anand2532/TokenKey-RT/docs/README.md

# docs

Project documentation: baseline specifications, design decisions, pin mapping, test plans and bring-up notes.
