anand2532/TokenKey-RT/software/poc-prototype/data/README.md

Data is not committed. Run ../fetch_data.sh from software/poc-prototype/ to recreate it.
