anand2532/TokenKey-RT/enclosure/exports/interference_report.md

# Interference check

Board ref e2e5ff9; clash threshold 0.3 mm; header 3.0, module 2.65, J2 y 5.0, shaft tip 24.5, knob H 16.5.

Pairs checked (bbox within 3 mm): 384; CLASH/TIGHT: 0

| kind | A | B | min clearance (mm) | overlap (mm3) | status |
|---|---|---|---|---|---|
| part-board | top_shell | pcb | 0.00 | 0.000 | fit/contact |
| part-board | bottom_tray | pcb | 0.00 | 0.000 | fit/contact |
| part-part | top_shell | bottom_tray | 0.00 | 0.000 | fit/contact |
| part-part | top_shell | button_cap_btn1 | 0.00 | 0.000 | fit/contact |
| part-part | top_shell | button_cap_btn2 | 0.00 | 0.000 | fit/contact |
| part-part | top_shell | light_pipe | 0.00 | 0.000 | fit/contact |
| part-part | bottom_tray | hatch_cover | 0.00 | 0.000 | fit/contact |
| part-part | bottom_tray | ballast | 0.00 | 0.000 | fit/contact |
| part-part | bottom_tray | feet | 0.00 | 0.000 | fit/contact |
| part-part | hatch_cover | feet | 0.00 | 0.000 | fit/contact |
| part-part | knob | knob_sleeve | 0.01 | 0.000 | fit/contact |
| part-board | knob_sleeve | SW2 EC11 body+shaft | 0.02 | 0.000 | fit/contact |
| part-board | top_shell | OLED module PCB | 0.15 | 0.000 | fit/contact |
| motion | knob@full-push | top_shell | 0.15 | 0.000 | fit/contact |
| part-part | top_shell | knob | 0.15 | 0.000 | fit/contact |
| part-board | light_pipe | D1 (LED) | 0.20 | 0.000 | fit/contact |
| part-board | button_cap_btn1 | SW3 (SW) | 0.21 | 0.000 | fit/contact |
| part-board | button_cap_btn2 | SW4 (SW) | 0.21 | 0.000 | fit/contact |
| part-board | top_shell | J1 USB-C body | 0.30 | 0.000 | ok |
| part-board | bottom_tray | SW1 (SW) | 0.30 | 0.000 | ok |
| part-board | top_shell | OLED glass | 0.35 | 0.000 | ok |
| part-board | top_shell | OLED FPC bend | 0.35 | 0.000 | ok |
| part-board | ballast | C3 (C DNP) | 0.35 | 0.000 | ok |
| part-board | ballast | C40 (C) | 0.35 | 0.000 | ok |
| part-board | ballast | C4 (C DNP) | 0.35 | 0.000 | ok |
| part-board | ballast | THT tails | 0.48 | 0.000 | ok |
| part-board | top_shell | SW2 EC11 body+shaft | 0.50 | 0.000 | ok |
| part-board | bottom_tray | L1 (L DNP) | 0.50 | 0.000 | ok |
| part-board | button_cap_btn1 | pcb | 0.50 | 0.000 | ok |
| part-board | button_cap_btn2 | pcb | 0.50 | 0.000 | ok |
| part-board | knob | SW2 EC11 body+shaft | 0.50 | 0.000 | ok |
| part-board | ballast | L1 (L DNP) | 0.50 | 0.000 | ok |
| part-board | ballast | SW1 (SW) | 0.50 | 0.000 | ok |
| part-board | ballast | U3 (SOT-23-5 DNP) | 0.51 | 0.000 | ok |
| part-part | ballast | feet | 0.60 | 0.000 | ok |
| part-board | top_shell | U4 (SOIC-8) | 0.60 | 0.000 | ok |
| part-board | ballast | C28 (C) | 0.75 | 0.000 | ok |
| part-board | ballast | C27 (C) | 0.75 | 0.000 | ok |
| part-board | ballast | C36 (C) | 0.75 | 0.000 | ok |
| part-board | ballast | C31 (C) | 0.75 | 0.000 | ok |
| part-board | ballast | C7 (C) | 0.75 | 0.000 | ok |
| part-board | ballast | C38 (C) | 0.75 | 0.000 | ok |
| part-board | ballast | U5 (Winbond DNP) | 0.75 | 0.000 | ok |
| part-board | ballast | C23 (C) | 0.75 | 0.000 | ok |
| part-board | ballast | C19 (C) | 0.75 | 0.000 | ok |
| part-board | ballast | C37 (C) | 0.75 | 0.000 | ok |
| part-board | ballast | R3 (R) | 0.75 | 0.000 | ok |
| part-board | ballast | C41 (C) | 0.75 | 0.000 | ok |
| part-board | ballast | C21 (C) | 0.75 | 0.000 | ok |
| part-board | ballast | C9 (C) | 0.75 | 0.000 | ok |
| part-board | ballast | C15 (C) | 0.75 | 0.000 | ok |
| part-board | ballast | R11 (R DNP) | 0.75 | 0.000 | ok |
| part-board | ballast | C50 (C DNP) | 0.75 | 0.000 | ok |
| part-board | ballast | C6 (C) | 0.75 | 0.000 | ok |
| part-board | ballast | C16 (C) | 0.75 | 0.000 | ok |
| part-board | ballast | C8 (C) | 0.75 | 0.000 | ok |
| part-board | ballast | C42 (C) | 0.75 | 0.000 | ok |
| part-board | ballast | C43 (C) | 0.75 | 0.000 | ok |
| part-board | ballast | R7 (R) | 0.75 | 0.000 | ok |
| part-board | ballast | R10 (R DNP) | 0.75 | 0.000 | ok |
| part-board | ballast | C29 (C) | 0.75 | 0.000 | ok |
| part-board | ballast | C24 (C) | 0.75 | 0.000 | ok |
| part-board | ballast | C25 (C) | 0.75 | 0.000 | ok |
| part-board | ballast | C10 (C) | 0.75 | 0.000 | ok |
| part-board | ballast | C14 (C) | 0.75 | 0.000 | ok |
| part-board | ballast | C34 (C) | 0.75 | 0.000 | ok |
| part-board | ballast | C5 (C) | 0.75 | 0.000 | ok |
| part-board | ballast | C33 (C) | 0.75 | 0.000 | ok |
| part-board | top_shell | J2 pin tips | 0.80 | 0.000 | ok |
| part-board | bottom_tray | U5 (Winbond DNP) | 0.97 | 0.000 | ok |
| part-board | bottom_tray | THT tails | 1.00 | 0.000 | ok |
| part-board | hatch_cover | THT tails | 1.00 | 0.000 | ok |

Rows with clearance >= 1.0 mm and no problem are omitted.

## OLED vs USB-C (board-board)

| A | B | min 3-D clearance (mm) | overlap (mm3) | status |
|---|---|---|---|---|
| OLED FPC bend | J1 USB-C body | 1.72 | 0.000 | ok |
| OLED module PCB | J1 USB-C body | 1.24 | 0.000 | ok |
| OLED back feature (band) | J1 USB-C body | 15.30 | 0.000 | ok |

- Module PCB edge -> USB-C body, plan: **+1.24 mm**
- FPC bend (far/south edge, 14.5 mm wide, 0.4 +- 0.2 mm inside the outline, no wrap; modelled at the worst case) -> USB-C body, plan: **+1.44 mm** (ok)
- J2 pin-row y 5.0 (from board_ref e2e5ff9)
