anand2532/TokenKey-RT/docs/renders/placement-bottom.png

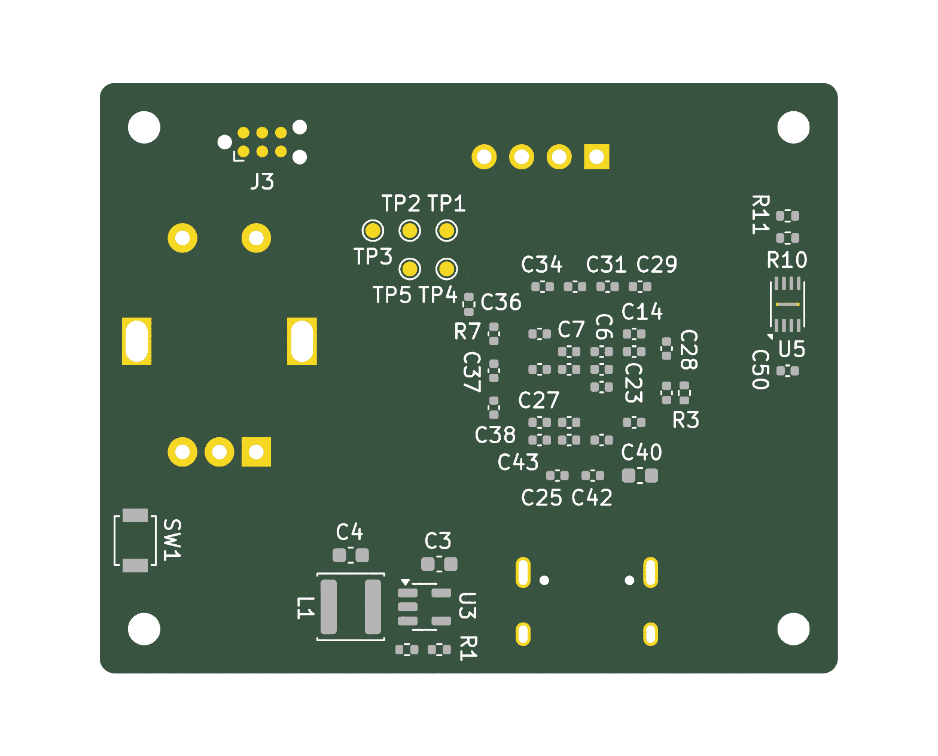
docs/renders/placement-bottom.png
