anand2532/TokenKey-RT/docs/renders/placement-top.png

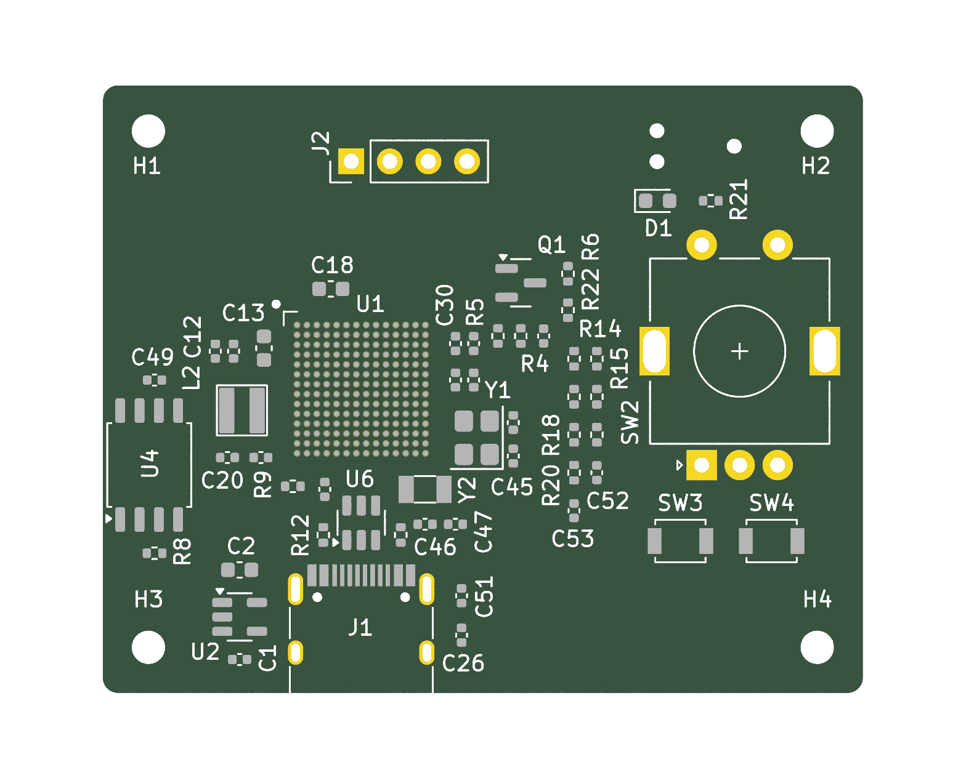
docs/renders/placement-top.png
