anand2532/TokenKey-RT/enclosure/renders/bottom.png

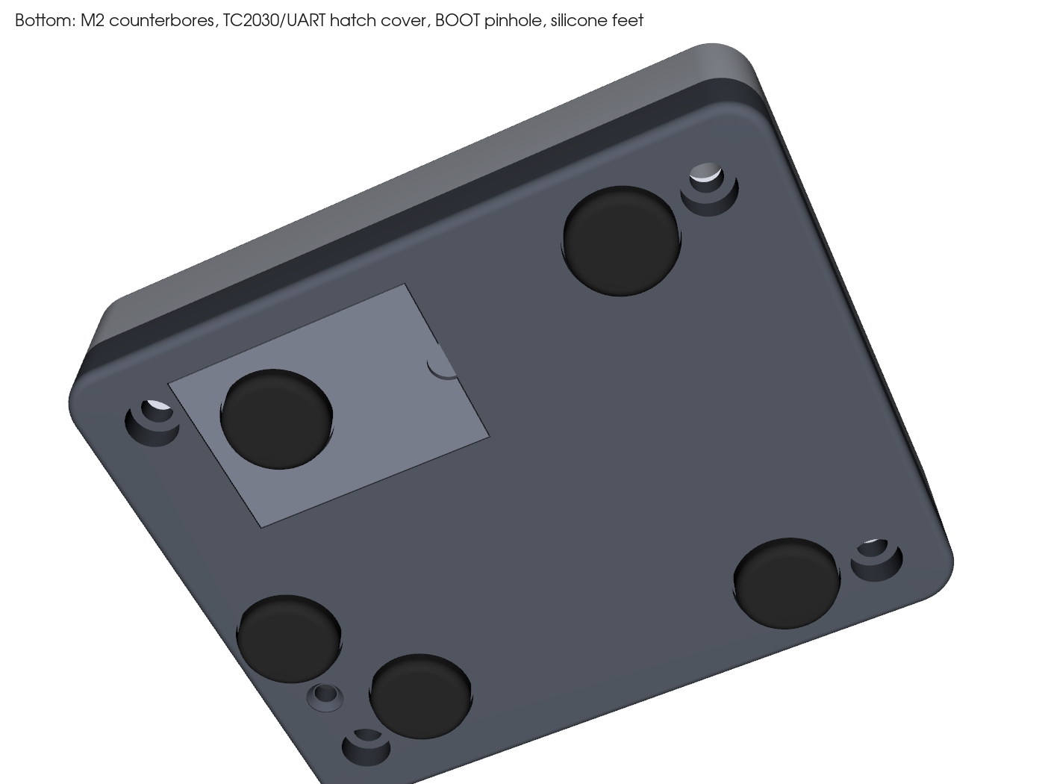
enclosure/renders/bottom.png
