anand2532/TokenKey-RT/enclosure/renders/exploded.png

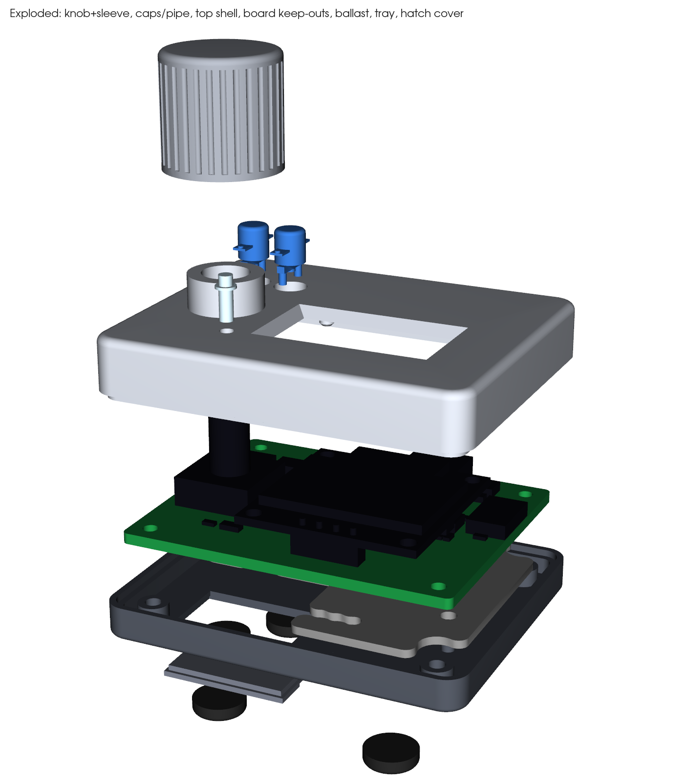
enclosure/renders/exploded.png
