anand2532/TokenKey-RT/enclosure/renders/iso.png

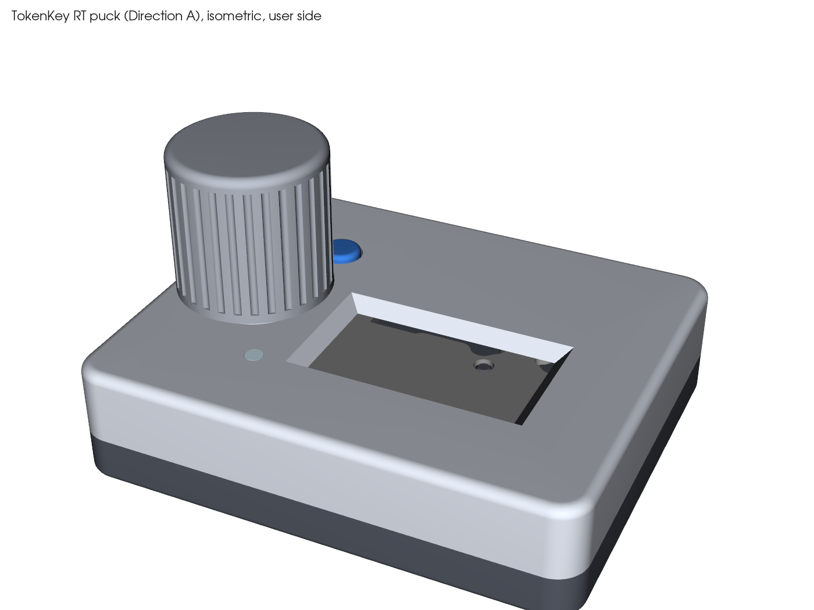
enclosure/renders/iso.png
