anand2532/TokenKey-RT/enclosure/renders/rear.png

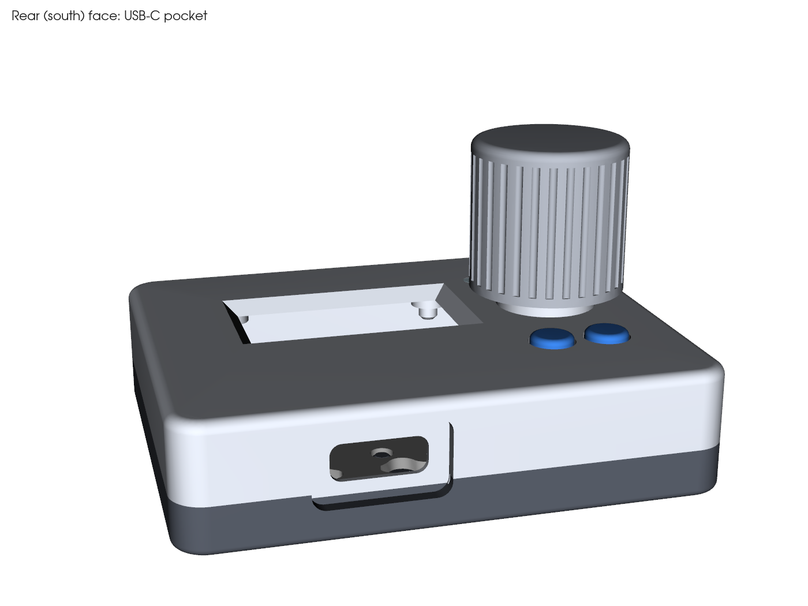
enclosure/renders/rear.png
