anand2532/TokenKey-RT/enclosure/renders/section_oled_usbc.png

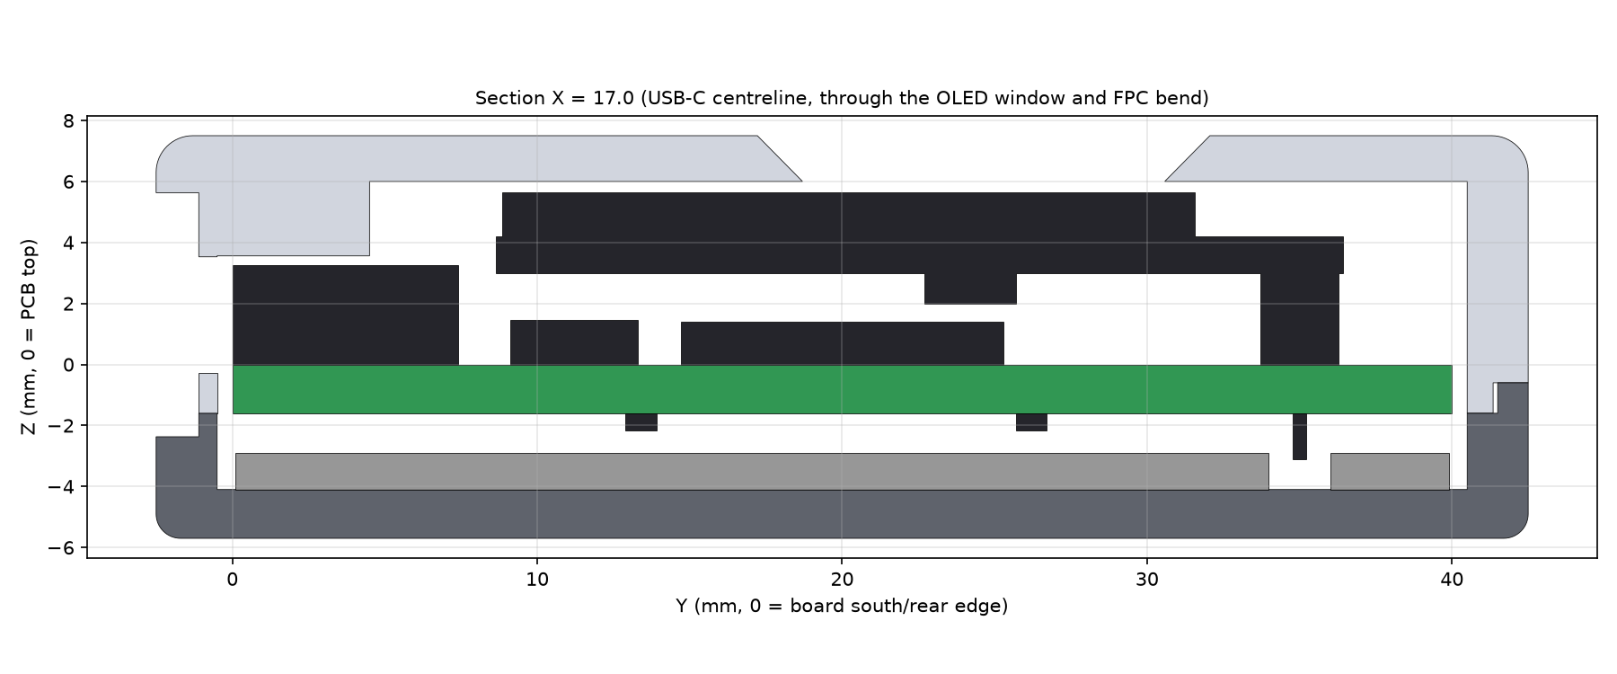
enclosure/renders/section_oled_usbc.png
