anand2532/TokenKey-RT/fab/hand_assembly.csv

Item | Designator | Qty | Description | MPN | LCSC Part # | Step | Notes
knob | SW2-knob | 1 | printed knob + brass sleeve, see enclosure hardware BOM | enclosure/exports/knob.* + knob_sleeve.* |  | 3 | Printed PETG knob (enclosure/exports/knob.*) with brass sleeve; enclosure hardware BOM: enclosure/BOM.md
