anand2532/TokenKey-RT/enclosure/exports/button_cap_btn2.step

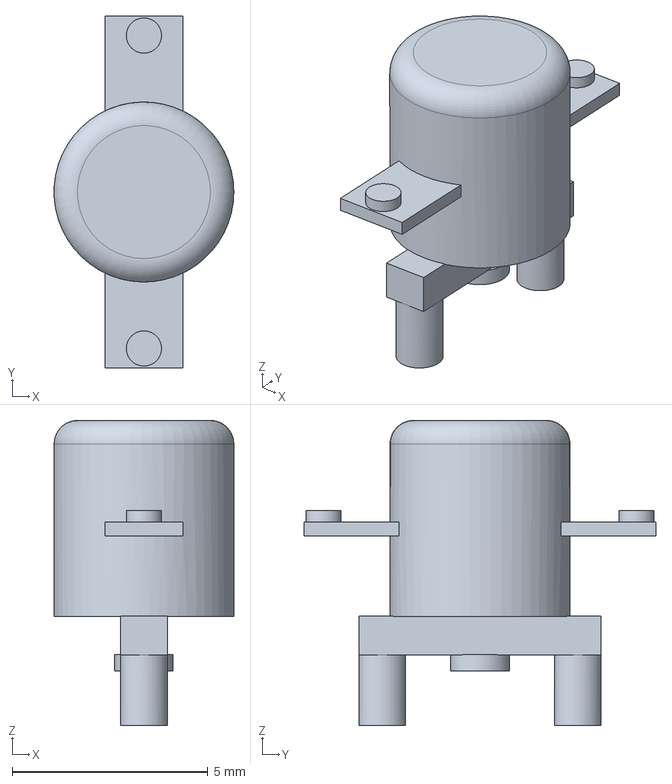
[picture p9: CAD file, 2026-10-21]
enclosure/exports/button_cap_btn2.step
4.60 x 9.00 x 7.80 mm
