anand2532/TokenKey-RT/enclosure/exports/print/tolerance_coupon.stl

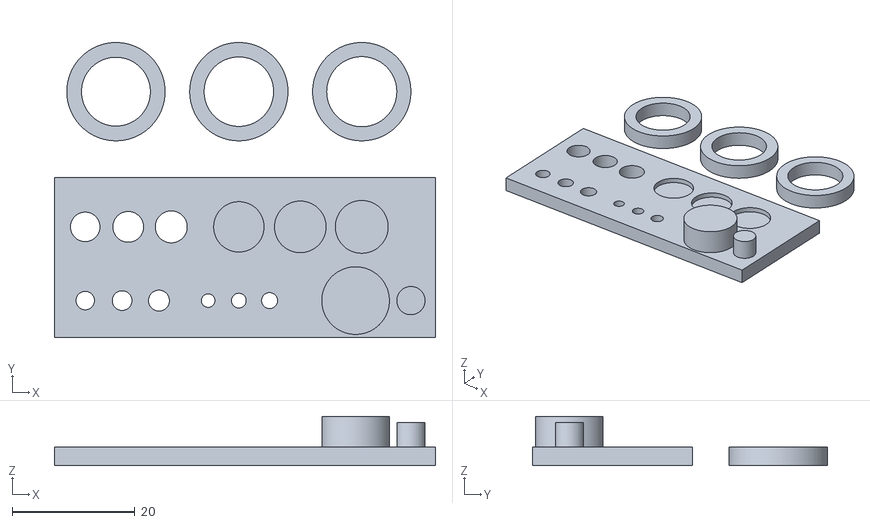
[picture p10: CAD file, 2026-10-21]
enclosure/exports/print/tolerance_coupon.stl
62.0 x 48.0 x 8.00
