anand2532/TokenKey-RT/enclosure/freecad/puck.FCStd

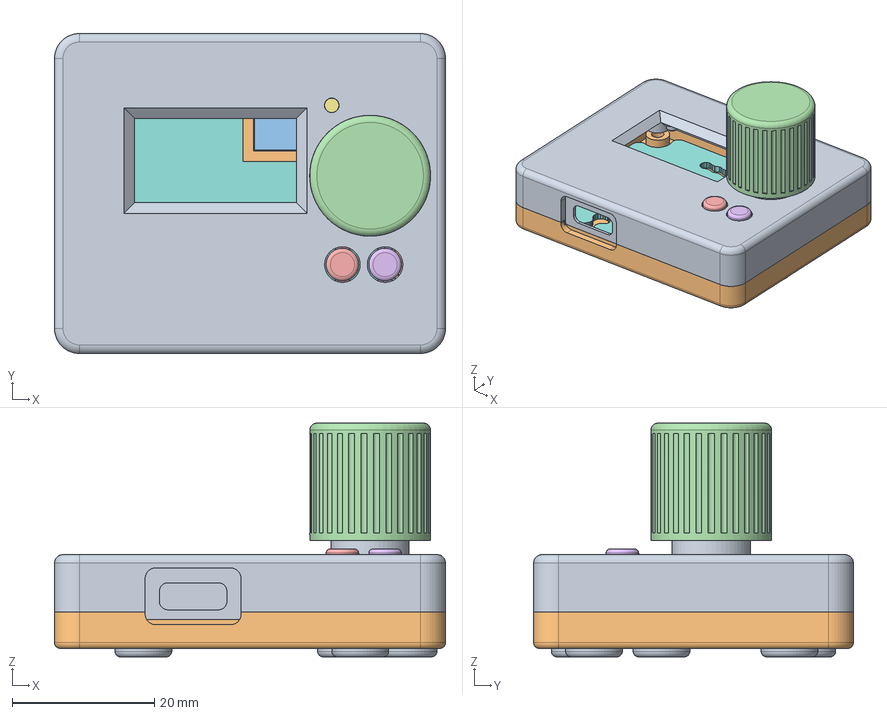
[picture p11: CAD file, 2026-10-21]
enclosure/freecad/puck.FCStd
55.0 x 45.0 x 32.9 mm
top_shell
bottom_tray
hatch_cover
knob
button_cap_btn1
button_cap_btn2
light_pipe
ballast
feet
knob_sleeve
