anand2532/TokenKey-RT/enclosure/exports/top_shell.step

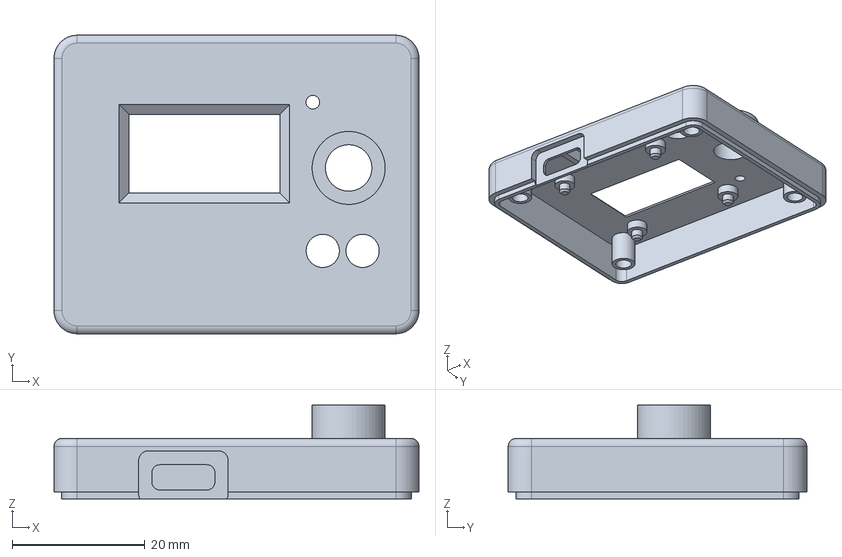
[picture p12: CAD file, 2026-10-21]
enclosure/exports/top_shell.step
55.0 x 45.0 x 14.1 mm
