anand2532/TokenKey-RT/enclosure/exports/bottom_tray.step

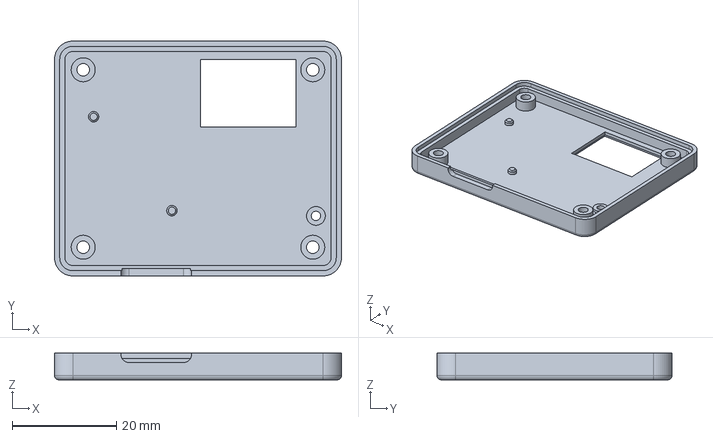
[picture p13: CAD file, 2026-10-21]
enclosure/exports/bottom_tray.step
55.0 x 45.0 x 5.10 mm
