anand2532/TokenKey-RT/enclosure/exports/ballast.step

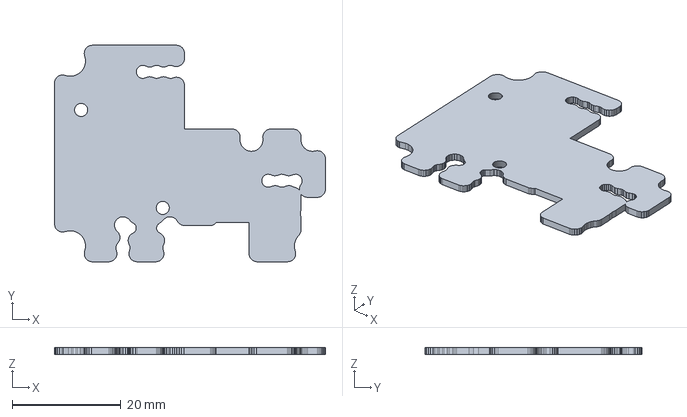
[picture p14: CAD file, 2026-10-21]
enclosure/exports/ballast.step
49.8 x 39.8 x 1.20 mm
