anand2532/TokenKey-RT/enclosure/exports/knob.step

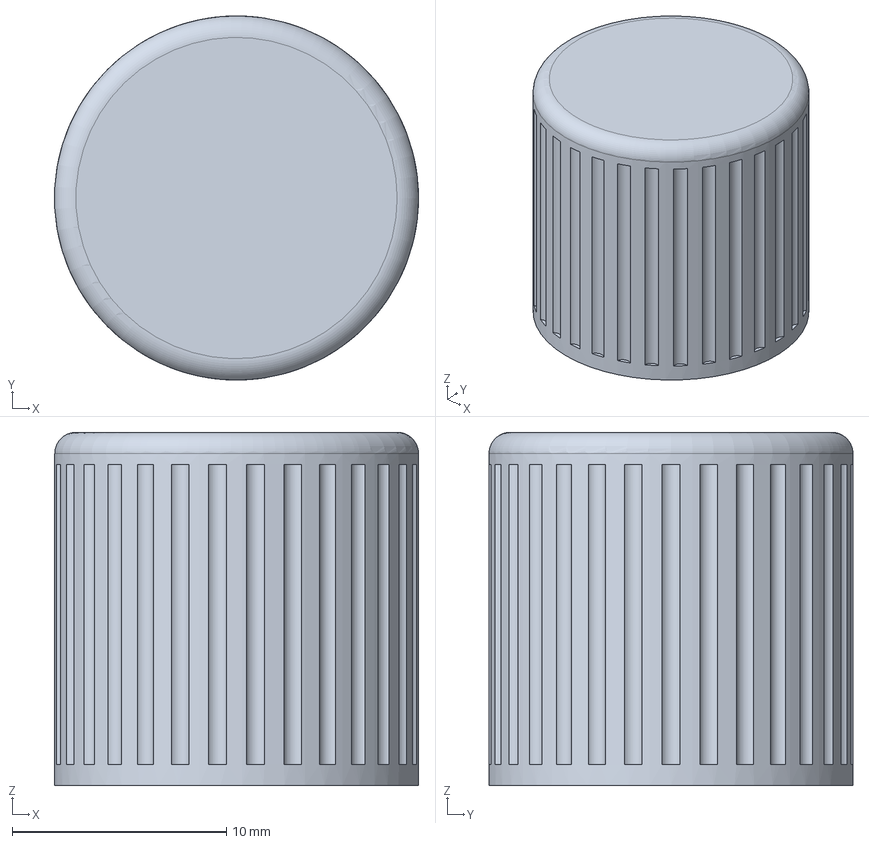
[picture p15: CAD file, 2026-10-21]
enclosure/exports/knob.step
17.0 x 17.0 x 16.5 mm
