anand2532/TokenKey-RT/enclosure/exports/hatch_cover.step

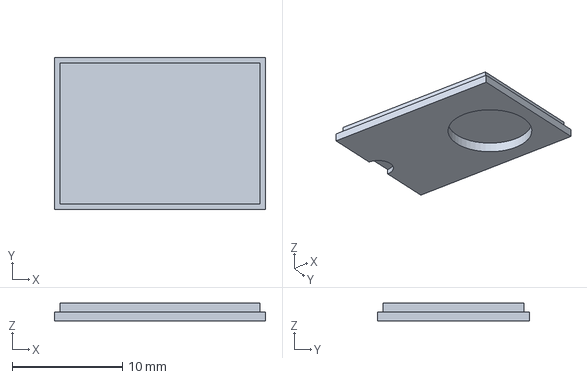
[picture p16: CAD file, 2026-10-21]
enclosure/exports/hatch_cover.step
19.1 x 13.8 x 1.60 mm
