anand2532/TokenKey-RT/enclosure/exports/board_keepout.step

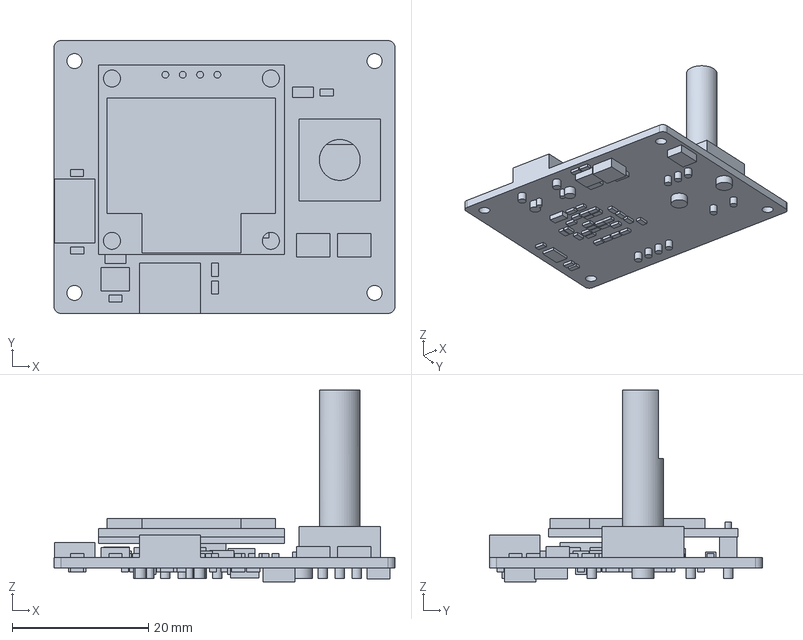
[picture p17: CAD file, 2026-10-21]
enclosure/exports/board_keepout.step
50.0 x 40.0 x 28.1 mm
