anand2532/TokenKey-RT/enclosure/exports/feet.step

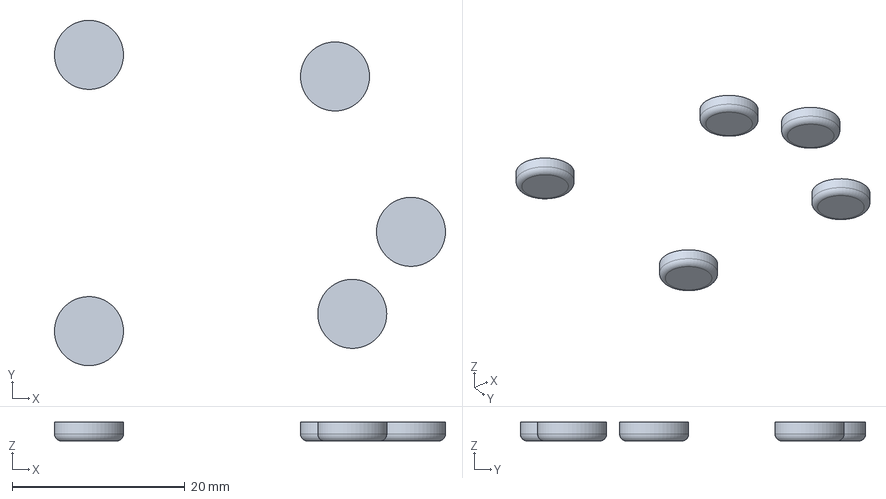
[picture p18: CAD file, 2026-10-21]
enclosure/exports/feet.step
45.3 x 40.0 x 2.20 mm
