anand2532/TokenKey-RT/enclosure/exports/light_pipe.step

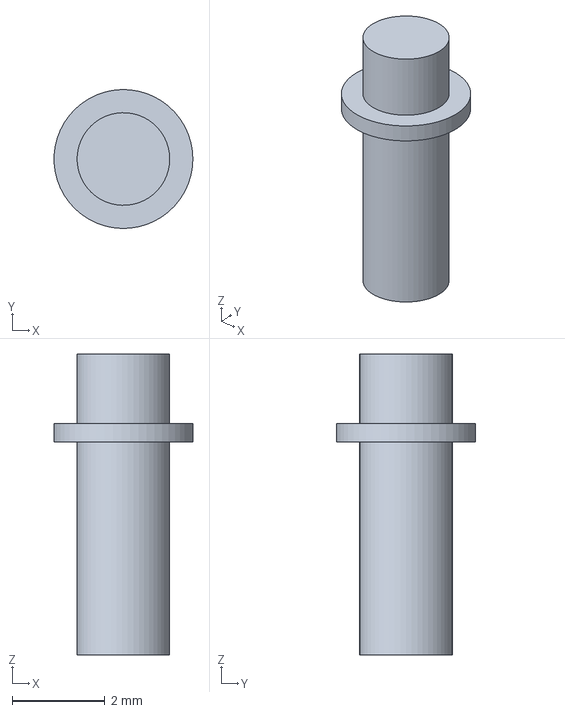
[picture p19: CAD file, 2026-10-21]
enclosure/exports/light_pipe.step
3.00 x 3.00 x 6.50 mm
