anand2532/TokenKey-RT/enclosure/exports/knob_sleeve.step

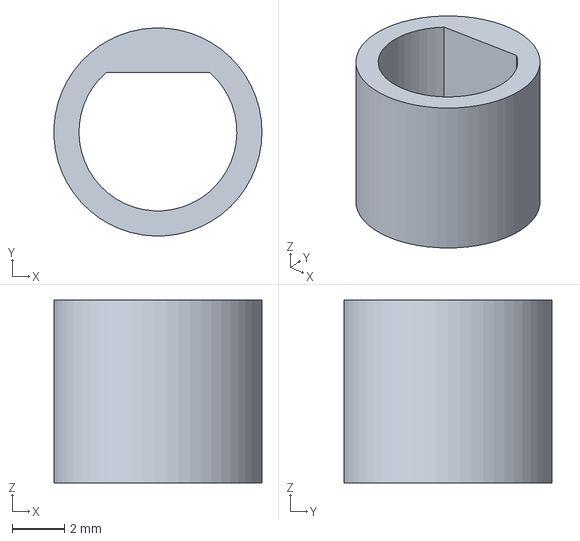
[picture p20: CAD file, 2026-10-21]
enclosure/exports/knob_sleeve.step
7.97 x 7.98 x 7.00 mm
