anand2532/TokenKey-RT/enclosure/exports/ballast_plate.dxf

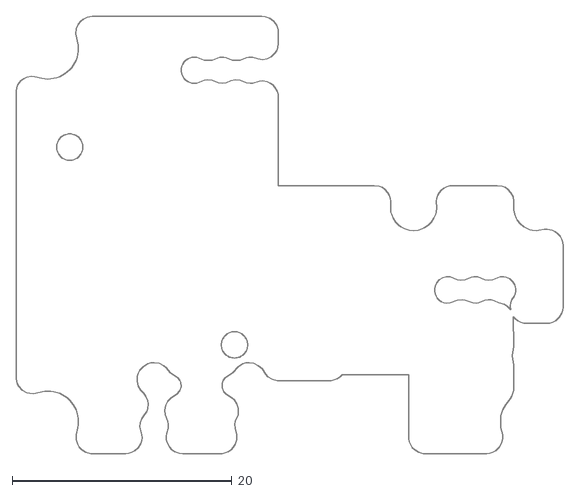
[picture p21: CAD file, 2026-10-21]
enclosure/exports/ballast_plate.dxf
49.8 x 39.8
