anand2532/TokenKey-RT/(list of files, cad)

Other CAD files:
enclosure/exports/button_cap_btn1.step
enclosure/exports/ballast.stl
enclosure/exports/bottom_tray.stl
enclosure/exports/button_cap_btn1.stl
enclosure/exports/button_cap_btn2.stl
enclosure/exports/feet.stl
enclosure/exports/hatch_cover.stl
enclosure/exports/knob.stl
enclosure/exports/knob_sleeve.stl
enclosure/exports/light_pipe.stl
enclosure/exports/print/bottom_tray.stl
enclosure/exports/print/button_cap_btn1.stl
enclosure/exports/print/button_cap_btn2.stl
enclosure/exports/print/hatch_cover.stl
enclosure/exports/print/knob.stl
enclosure/exports/print/light_pipe.stl
enclosure/exports/print/top_shell.stl
enclosure/exports/top_shell.stl
enclosure/freecad/assembly.FCStd
enclosure/freecad/exports/ballast.step
enclosure/freecad/exports/ballast.stl
enclosure/freecad/exports/bottom_tray.step
enclosure/freecad/exports/bottom_tray.stl
enclosure/freecad/exports/button_cap_btn1.step
enclosure/freecad/exports/button_cap_btn1.stl
enclosure/freecad/exports/button_cap_btn2.step
enclosure/freecad/exports/button_cap_btn2.stl
enclosure/freecad/exports/feet.step
enclosure/freecad/exports/feet.stl
enclosure/freecad/exports/hatch_cover.step
enclosure/freecad/exports/hatch_cover.stl
enclosure/freecad/exports/knob.step
enclosure/freecad/exports/knob.stl
enclosure/freecad/exports/knob_sleeve.step
enclosure/freecad/exports/knob_sleeve.stl
enclosure/freecad/exports/light_pipe.step
enclosure/freecad/exports/light_pipe.stl
enclosure/freecad/exports/top_shell.step
enclosure/freecad/exports/top_shell.stl
