anand2532/TokenKey-RT/hardware/schematic/TokenKey-RT.kicad_pcb

## KiCad design hardware/schematic/TokenKey-RT.kicad_pcb (2026-10-21)

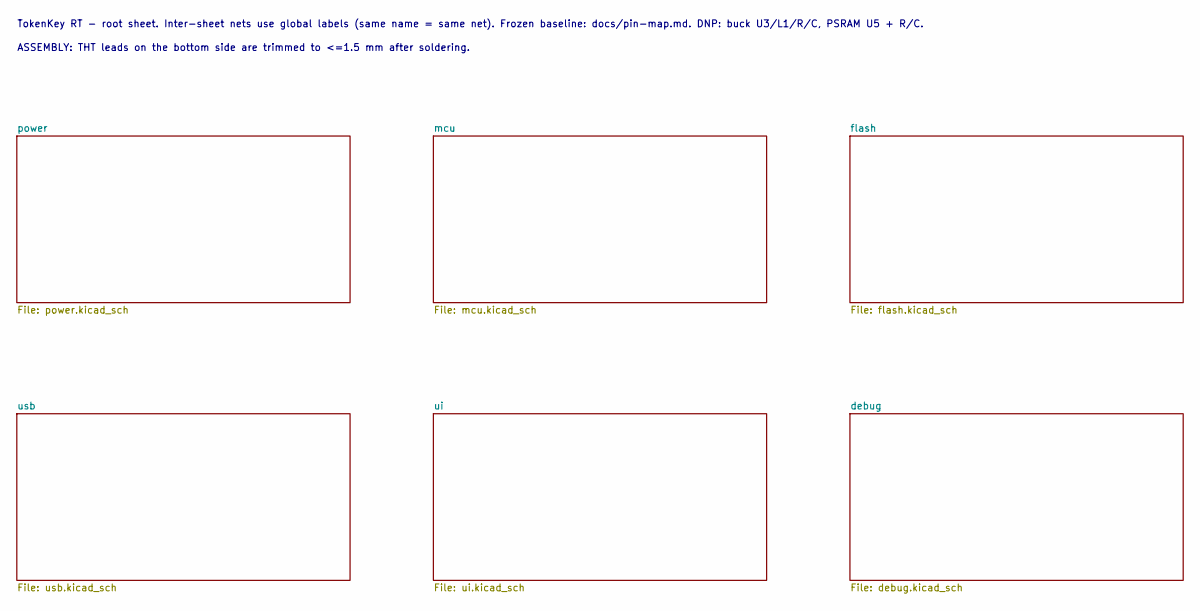
[picture p22: schematic TokenKey-RT.kicad_sch, TokenKey RT - i.MX RT1062 USB accessory]

Notes on the sheet:
TokenKey RT - root sheet. Inter-sheet nets use global labels (same name = same net). Frozen baseline: docs/pin-map.md. DNP: buck U3/L1/R/C, PSRAM U5 + R/C.
ASSEMBLY: THT leads on the bottom side are trimmed to <=1.5 mm after soldering.

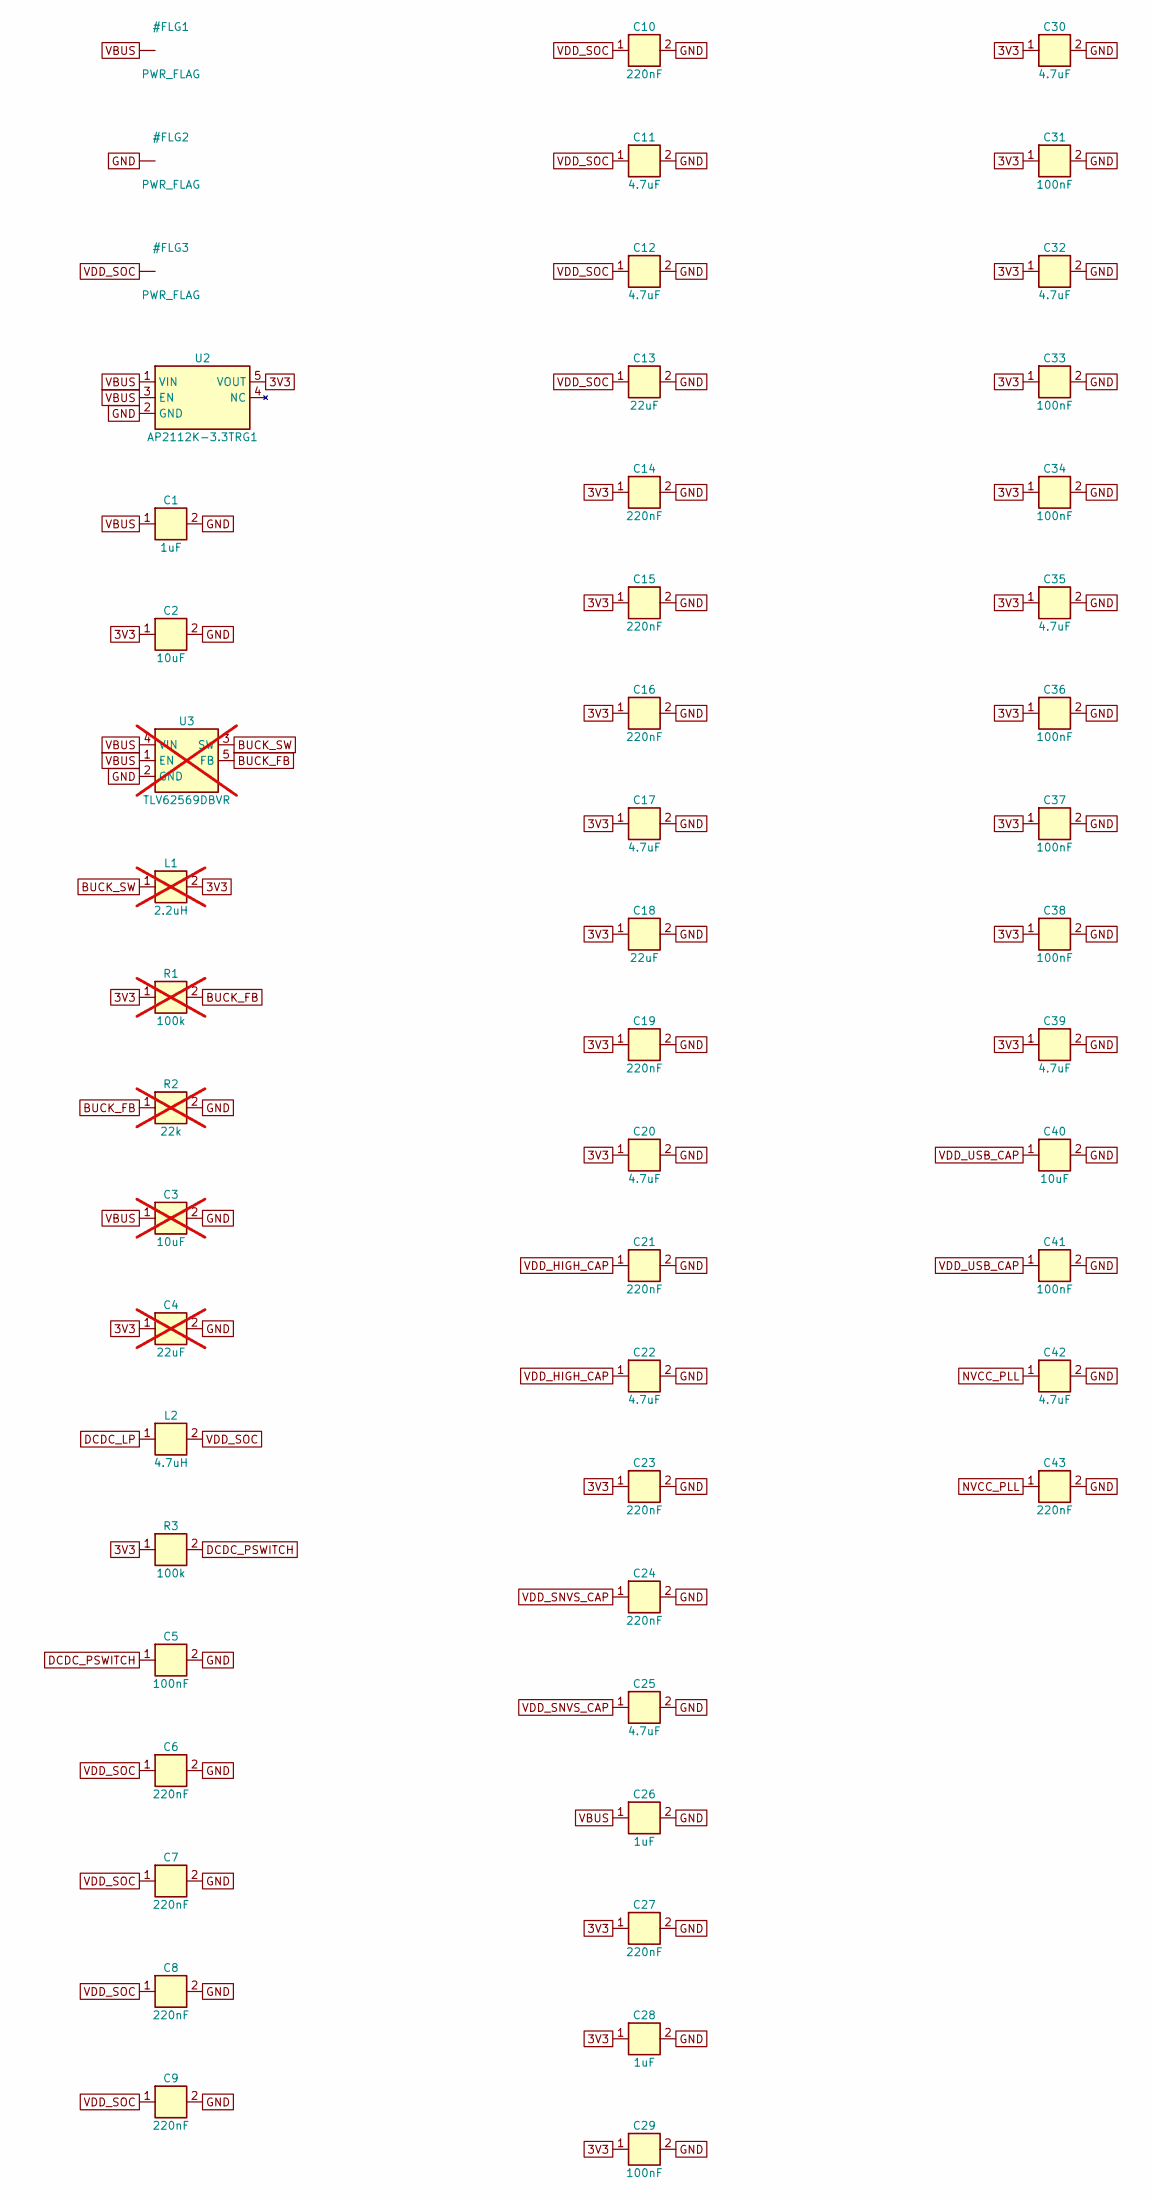
[picture p23: schematic power.kicad_sch, Power: VBUS in, 3V3 LDO / DNP buck, RT1062 DCDC + decoupling]

Parts:
C1, C26, C28: 1uF; C_0402_1005Metric; MPN CL05A105KA5NQNC; LCSC C52923
C2, C40: 10uF; C_0603_1608Metric; MPN CL10A106KP8NNNC; LCSC C19702
C3: 10uF; C_0603_1608Metric; MPN CL10A106KP8NNNC; LCSC C19702; not fitted
C4: 22uF; C_0603_1608Metric; MPN CL10A226MQ8NRNC; LCSC C59461; not fitted
C5, C29, C31, C33, C34, C36, C37, C38, C41: 100nF; C_0402_1005Metric; MPN CL05B104KO5NNNC; LCSC C1525
C6, C7, C8, C9, C10, C14, C15, C16, C19, C21, C23, C24, C27, C43: 220nF; C_0402_1005Metric; MPN CL05A224KA5NNNC; LCSC C47129
C11, C12, C17, C20, C22, C25, C30, C32, C35, C39, C42: 4.7uF; C_0402_1005Metric; MPN CL05A475MP5NRNC; LCSC C23733
C13, C18: 22uF; C_0603_1608Metric; MPN CL10A226MQ8NRNC; LCSC C59461
L1: 2.2uH; L_Sunlord_SWPA4020S; MPN SWPA4020S2R2MT; LCSC C83423; not fitted
L2: 4.7uH; L_3.0x3.0mm_TDK_VLS3015CX; MPN VLS3015CX-4R7M-1; LCSC C3220938
R1: 100k; R_0402_1005Metric; MPN 0402WGF1003TCE; LCSC C25741; not fitted
R2: 22k; R_0402_1005Metric; MPN 0402WGF2202TCE; LCSC C25768; not fitted
R3: 100k; R_0402_1005Metric; MPN 0402WGF1003TCE; LCSC C25741
U2: AP2112K-3.3TRG1; SOT-23-5; MPN AP2112K-3.3TRG1; LCSC C51118
U3: TLV62569DBVR; SOT-23-5; MPN TLV62569DBVR; LCSC C141836; not fitted

Connections:
3V3: C2.1, C4.1, C14.1, C15.1, C16.1, C17.1, C18.1, C19.1, C20.1, C23.1, C27.1, C28.1, C29.1, C30.1, C31.1, C32.1, C33.1, C34.1, C35.1, C36.1, C37.1, C38.1, C39.1, L1.2, R1.1, R3.1, U2.5 (VOUT); also elsewhere on the board
BUCK_FB: R1.2, R2.1, U3.5 (FB)
BUCK_SW: L1.1, U3.3 (SW)
DCDC_LP: L2.1; also elsewhere on the board
DCDC_PSWITCH: C5.1, R3.2; also elsewhere on the board
GND: C1.2, C2.2, C3.2, C4.2, C5.2, C6.2, C7.2, C8.2, C9.2, C10.2, C11.2, C12.2, C13.2, C14.2, C15.2, C16.2, C17.2, C18.2, C19.2, C20.2, C21.2, C22.2, C23.2, C24.2, C25.2, C26.2, C27.2, C28.2, C29.2, C30.2, C31.2, C32.2, C33.2, C34.2, C35.2, C36.2, C37.2, C38.2, C39.2, C40.2, C41.2, C42.2, C43.2, R2.2, U2.2 (GND), U3.2 (GND); also elsewhere on the board
NVCC_PLL: C42.1, C43.1; also elsewhere on the board
VBUS: C1.1, C3.1, C26.1, U2.1 (VIN), U2.3 (EN), U3.1 (EN), U3.4 (VIN); also elsewhere on the board
VDD_HIGH_CAP: C21.1, C22.1; also elsewhere on the board
VDD_SNVS_CAP: C24.1, C25.1; also elsewhere on the board
VDD_SOC: C6.1, C7.1, C8.1, C9.1, C10.1, C11.1, C12.1, C13.1, L2.2; also elsewhere on the board
VDD_USB_CAP: C40.1, C41.1; also elsewhere on the board

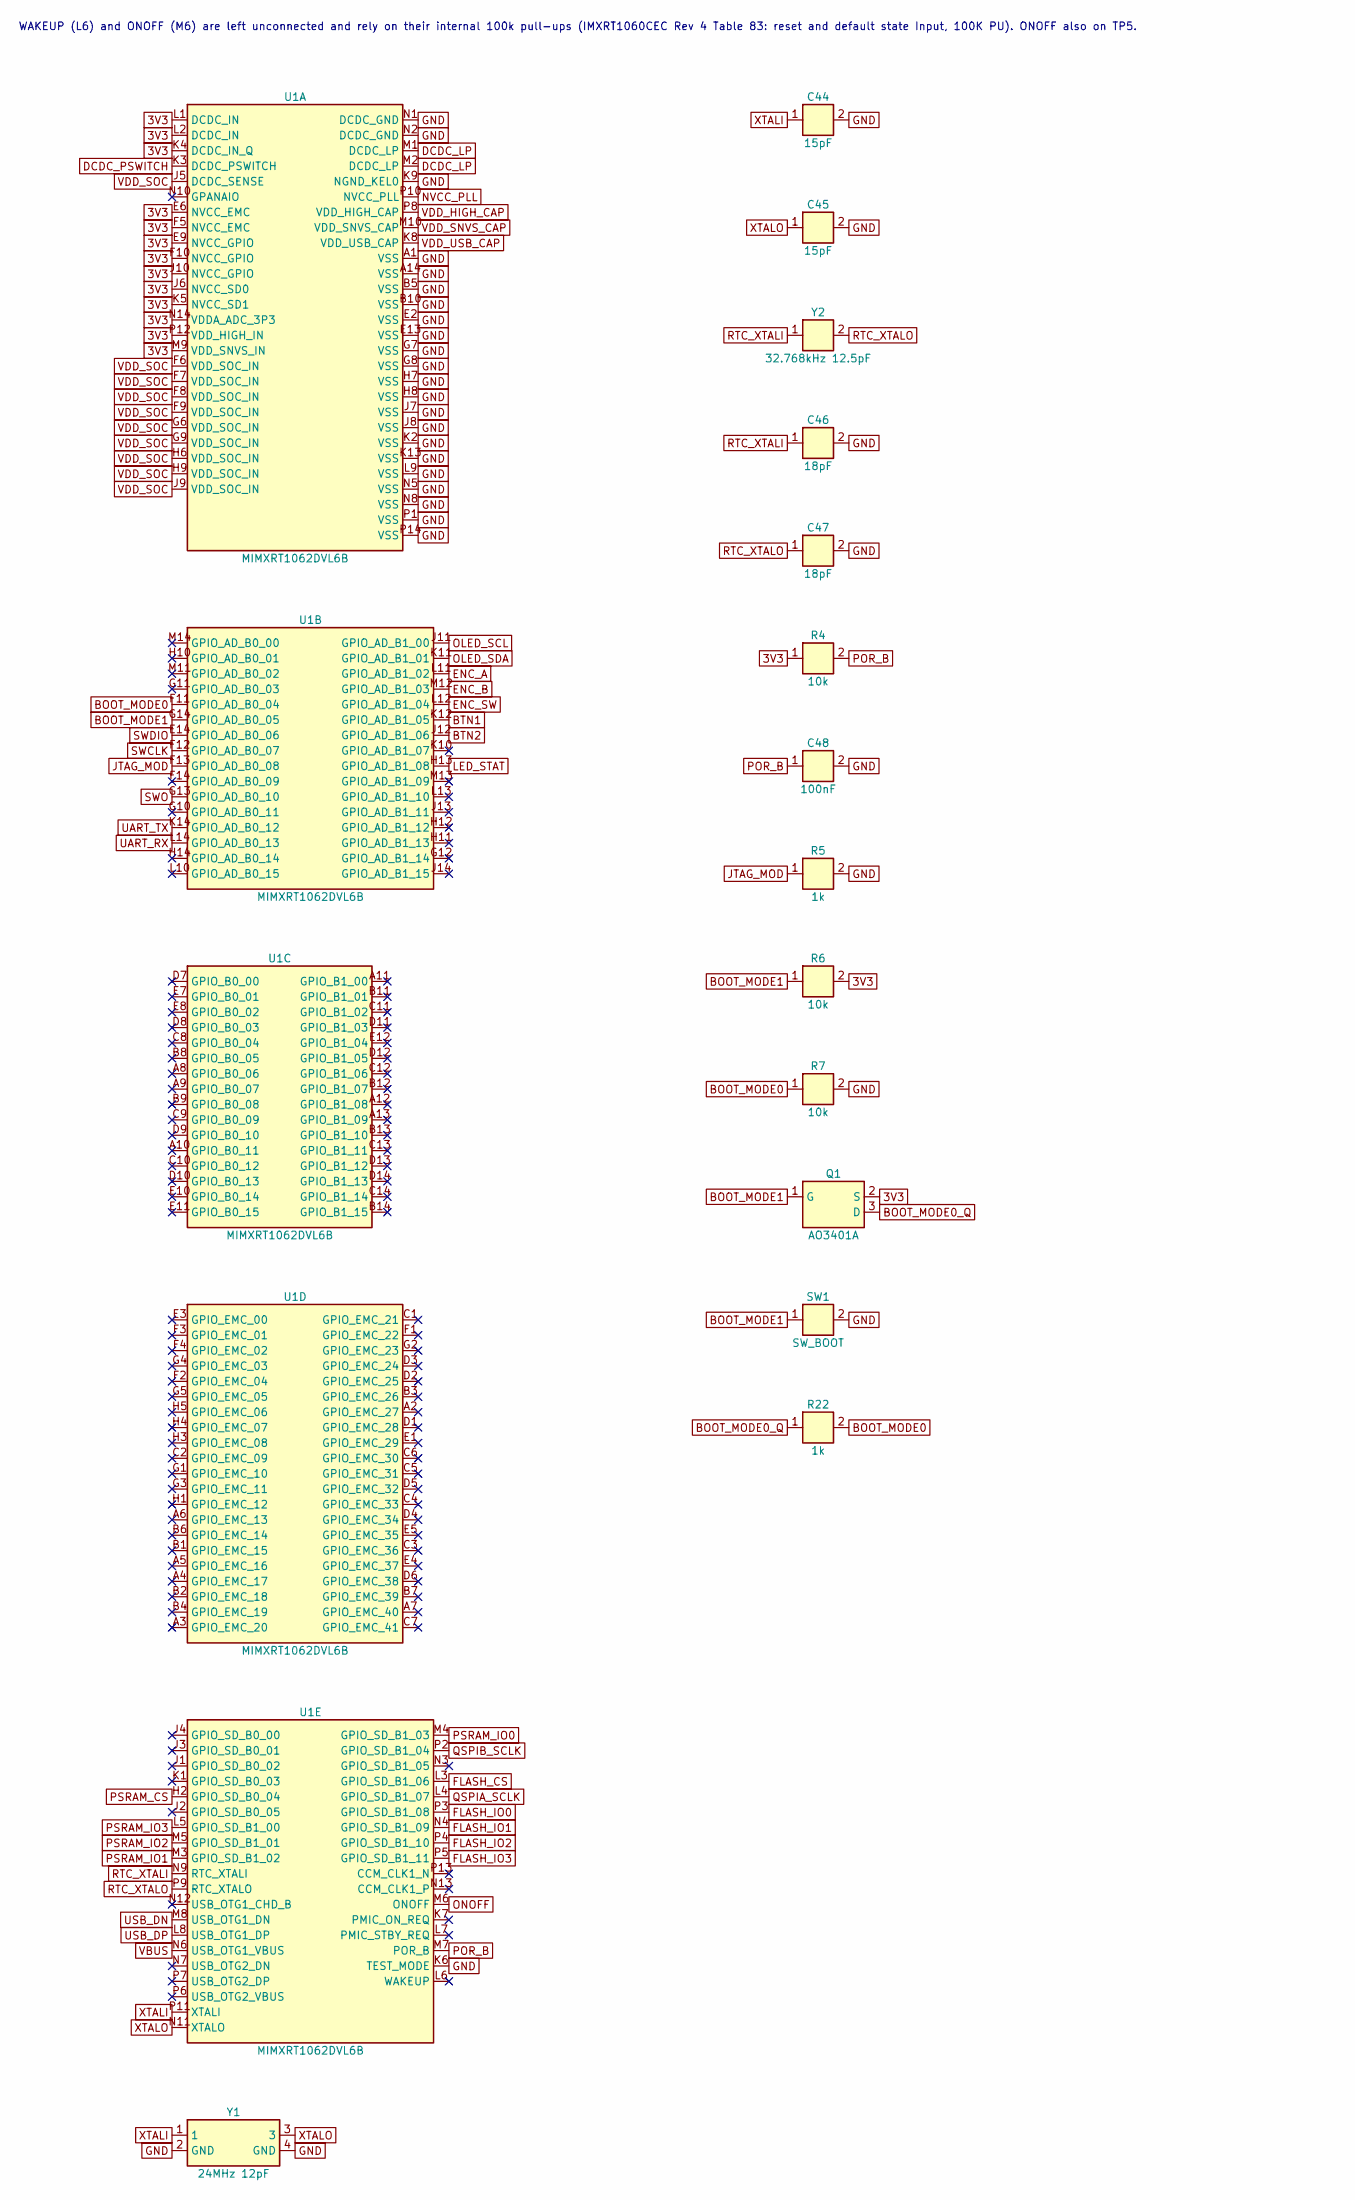
[picture p24: schematic mcu.kicad_sch, MCU: MIMXRT1062DVL6B, clocks, reset, boot]

Parts:
C44, C45: 15pF; C_0402_1005Metric; MPN 0402CG150J500NT; LCSC C1548
C46, C47: 18pF; C_0402_1005Metric; MPN 0402CG180J500NT; LCSC C1549
C48: 100nF; C_0402_1005Metric; MPN CL05B104KO5NNNC; LCSC C1525
Q1: AO3401A; SOT-23; MPN AO3401A; LCSC C15127
R4, R6, R7: 10k; R_0402_1005Metric; MPN 0402WGF1002TCE; LCSC C25744
R5, R22: 1k; R_0402_1005Metric; MPN 0402WGF1001TCE; LCSC C11702
SW1: SW_BOOT; SW_SPST_B3U-1000P; MPN B3U-1000P; LCSC C231329
U1: MIMXRT1062DVL6B; NXP_MAPBGA-196_10x10mm_Layout14x14_P0.65mm; MPN MIMXRT1062DVL6B; LCSC C2847497
Y1: 24MHz 12pF; Crystal_SMD_3225-4Pin_3.2x2.5mm; MPN X322524MOB4SI; LCSC C70590
Y2: 32.768kHz 12.5pF; Crystal_SMD_3215-2Pin_3.2x1.5mm; MPN ABS07-32.768KHZ-T; LCSC C130253

Connections:
3V3: Q1.2 (S), R4.1, R6.2, U1.E6 (NVCC_EMC), U1.E9 (NVCC_GPIO), U1.F5 (NVCC_EMC), U1.F10 (NVCC_GPIO), U1.J6 (NVCC_SD0), U1.J10 (NVCC_GPIO), U1.K4 (DCDC_IN_Q), U1.K5 (NVCC_SD1), U1.L1 (DCDC_IN), U1.L2 (DCDC_IN), U1.M9 (VDD_SNVS_IN), U1.N14 (VDDA_ADC_3P3), U1.P12 (VDD_HIGH_IN); also elsewhere on the board
BOOT_MODE0: R7.1, R22.2, U1.F11 (GPIO_AD_B0_04)
BOOT_MODE0_Q: Q1.3 (D), R22.1
BOOT_MODE1: Q1.1 (G), R6.1, SW1.1, U1.G14 (GPIO_AD_B0_05)
BTN1: U1.K12 (GPIO_AD_B1_05); also elsewhere on the board
BTN2: U1.J12 (GPIO_AD_B1_06); also elsewhere on the board
DCDC_LP: U1.M1 (DCDC_LP), U1.M2 (DCDC_LP); also elsewhere on the board
DCDC_PSWITCH: U1.K3 (DCDC_PSWITCH); also elsewhere on the board
ENC_A: U1.L11 (GPIO_AD_B1_02); also elsewhere on the board
ENC_B: U1.M12 (GPIO_AD_B1_03); also elsewhere on the board
ENC_SW: U1.L12 (GPIO_AD_B1_04); also elsewhere on the board
FLASH_CS: U1.L3 (GPIO_SD_B1_06); also elsewhere on the board
FLASH_IO0: U1.P3 (GPIO_SD_B1_08); also elsewhere on the board
FLASH_IO1: U1.N4 (GPIO_SD_B1_09); also elsewhere on the board
FLASH_IO2: U1.P4 (GPIO_SD_B1_10); also elsewhere on the board
FLASH_IO3: U1.P5 (GPIO_SD_B1_11); also elsewhere on the board
GND: C44.2, C45.2, C46.2, C47.2, C48.2, R5.2, R7.2, SW1.2, U1.A1 (VSS), U1.A14 (VSS), U1.B5 (VSS), U1.B10 (VSS), U1.E2 (VSS), U1.E13 (VSS), U1.G7 (VSS), U1.G8 (VSS), U1.H7 (VSS), U1.H8 (VSS), U1.J7 (VSS), U1.J8 (VSS), U1.K2 (VSS), U1.K6 (TEST_MODE), U1.K9 (NGND_KEL0), U1.K13 (VSS), U1.L9 (VSS), U1.N1 (DCDC_GND), U1.N2 (DCDC_GND), U1.N5 (VSS), U1.N8 (VSS), U1.P1 (VSS), U1.P14 (VSS), Y1.2 (GND), Y1.4 (GND); also elsewhere on the board
JTAG_MOD: R5.1, U1.F13 (GPIO_AD_B0_08)
LED_STAT: U1.H13 (GPIO_AD_B1_08); also elsewhere on the board
NVCC_PLL: U1.P10 (NVCC_PLL); also elsewhere on the board
OLED_SCL: U1.J11 (GPIO_AD_B1_00); also elsewhere on the board
OLED_SDA: U1.K11 (GPIO_AD_B1_01); also elsewhere on the board
ONOFF: U1.M6 (ONOFF); also elsewhere on the board
POR_B: C48.1, R4.2, U1.M7 (POR_B); also elsewhere on the board
PSRAM_CS: U1.H2 (GPIO_SD_B0_04); also elsewhere on the board
PSRAM_IO0: U1.M4 (GPIO_SD_B1_03); also elsewhere on the board
PSRAM_IO1: U1.M3 (GPIO_SD_B1_02); also elsewhere on the board
PSRAM_IO2: U1.M5 (GPIO_SD_B1_01); also elsewhere on the board
PSRAM_IO3: U1.L5 (GPIO_SD_B1_00); also elsewhere on the board
QSPIA_SCLK: U1.L4 (GPIO_SD_B1_07); also elsewhere on the board
QSPIB_SCLK: U1.P2 (GPIO_SD_B1_04); also elsewhere on the board
RTC_XTALI: C46.1, U1.N9 (RTC_XTALI), Y2.1
RTC_XTALO: C47.1, U1.P9 (RTC_XTALO), Y2.2
SWCLK: U1.F12 (GPIO_AD_B0_07); also elsewhere on the board
SWDIO: U1.E14 (GPIO_AD_B0_06); also elsewhere on the board
SWO: U1.G13 (GPIO_AD_B0_10); also elsewhere on the board
UART_RX: U1.L14 (GPIO_AD_B0_13); also elsewhere on the board
UART_TX: U1.K14 (GPIO_AD_B0_12); also elsewhere on the board
USB_DN: U1.M8 (USB_OTG1_DN); also elsewhere on the board
USB_DP: U1.L8 (USB_OTG1_DP); also elsewhere on the board
VBUS: U1.N6 (USB_OTG1_VBUS); also elsewhere on the board
VDD_HIGH_CAP: U1.P8 (VDD_HIGH_CAP); also elsewhere on the board
VDD_SNVS_CAP: U1.M10 (VDD_SNVS_CAP); also elsewhere on the board
VDD_SOC: U1.F6 (VDD_SOC_IN), U1.F7 (VDD_SOC_IN), U1.F8 (VDD_SOC_IN), U1.F9 (VDD_SOC_IN), U1.G6 (VDD_SOC_IN), U1.G9 (VDD_SOC_IN), U1.H6 (VDD_SOC_IN), U1.H9 (VDD_SOC_IN), U1.J5 (DCDC_SENSE), U1.J9 (VDD_SOC_IN); also elsewhere on the board
VDD_USB_CAP: U1.K8 (VDD_USB_CAP); also elsewhere on the board
XTALI: C44.1, U1.P11 (XTALI), Y1.1
XTALO: C45.1, U1.N11 (XTALO), Y1.3

Notes on the sheet:
WAKEUP (L6) and ONOFF (M6) are left unconnected and rely on their internal 100k pull-ups (IMXRT1060CEC Rev 4 Table 83: reset and default state Input, 100K PU). ONOFF also on TP5.

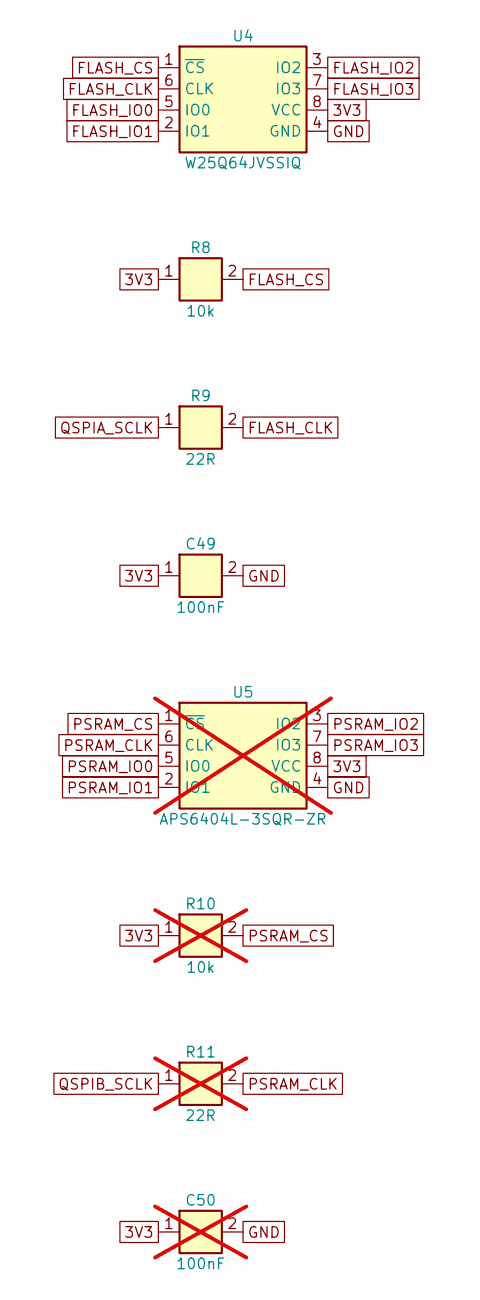
[picture p25: schematic flash.kicad_sch, FlexSPI A boot flash + DNP FlexSPI B PSRAM]

Parts:
C49: 100nF; C_0402_1005Metric; MPN CL05B104KO5NNNC; LCSC C1525
C50: 100nF; C_0402_1005Metric; MPN CL05B104KO5NNNC; LCSC C1525; not fitted
R8: 10k; R_0402_1005Metric; MPN 0402WGF1002TCE; LCSC C25744
R9: 22R; R_0402_1005Metric; MPN 0402WGF220JTCE; LCSC C25092
R10: 10k; R_0402_1005Metric; MPN 0402WGF1002TCE; LCSC C25744; not fitted
R11: 22R; R_0402_1005Metric; MPN 0402WGF220JTCE; LCSC C25092; not fitted
U4: W25Q64JVSSIQ; SOIC-8_5.3x5.3mm_P1.27mm; MPN W25Q64JVSSIQ; LCSC C179171
U5: APS6404L-3SQR-ZR; Winbond_USON-8-1EP_3x2mm_P0.5mm_EP0.2x1.6mm; MPN APS6404L-3SQR-ZR; LCSC C3040877; not fitted

Connections:
3V3: C49.1, C50.1, R8.1, R10.1, U4.8 (VCC), U5.8 (VCC); also elsewhere on the board
FLASH_CLK: R9.2, U4.6 (CLK)
FLASH_CS: R8.2, U4.1 (~CS); also elsewhere on the board
FLASH_IO0: U4.5 (IO0); also elsewhere on the board
FLASH_IO1: U4.2 (IO1); also elsewhere on the board
FLASH_IO2: U4.3 (IO2); also elsewhere on the board
FLASH_IO3: U4.7 (IO3); also elsewhere on the board
GND: C49.2, C50.2, U4.4 (GND), U5.4 (GND); also elsewhere on the board
PSRAM_CLK: R11.2, U5.6 (CLK)
PSRAM_CS: R10.2, U5.1 (~CS); also elsewhere on the board
PSRAM_IO0: U5.5 (IO0); also elsewhere on the board
PSRAM_IO1: U5.2 (IO1); also elsewhere on the board
PSRAM_IO2: U5.3 (IO2); also elsewhere on the board
PSRAM_IO3: U5.7 (IO3); also elsewhere on the board
QSPIA_SCLK: R9.1; also elsewhere on the board
QSPIB_SCLK: R11.1; also elsewhere on the board

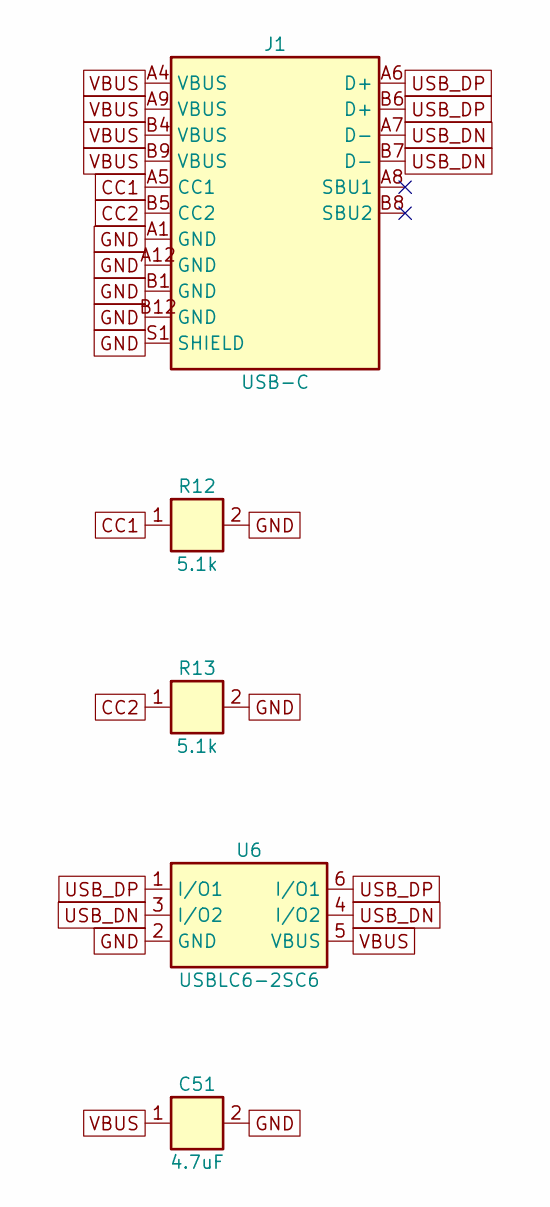
[picture p26: schematic usb.kicad_sch, USB-C device, CC Rd, ESD]

Parts:
C51: 4.7uF; C_0402_1005Metric; MPN CL05A475MP5NRNC; LCSC C23733
J1: USB-C; USB_C_Receptacle_HRO_TYPE-C-31-M-12; MPN TYPE-C-31-M-12; LCSC C165948
R12, R13: 5.1k; R_0402_1005Metric; MPN 0402WGF5101TCE; LCSC C25905
U6: USBLC6-2SC6; SOT-23-6; MPN USBLC6-2SC6; LCSC C7519

Connections:
CC1: J1.A5 (CC1), R12.1
CC2: J1.B5 (CC2), R13.1
GND: C51.2, J1.A1 (GND), J1.A12 (GND), J1.B1 (GND), J1.B12 (GND), J1.S1 (SHIELD), R12.2, R13.2, U6.2 (GND); also elsewhere on the board
USB_DN: J1.A7 (D-), J1.B7 (D-), U6.3 (I/O2), U6.4 (I/O2); also elsewhere on the board
USB_DP: J1.A6 (D+), J1.B6 (D+), U6.1 (I/O1), U6.6 (I/O1); also elsewhere on the board
VBUS: C51.1, J1.A4 (VBUS), J1.A9 (VBUS), J1.B4 (VBUS), J1.B9 (VBUS), U6.5 (VBUS); also elsewhere on the board

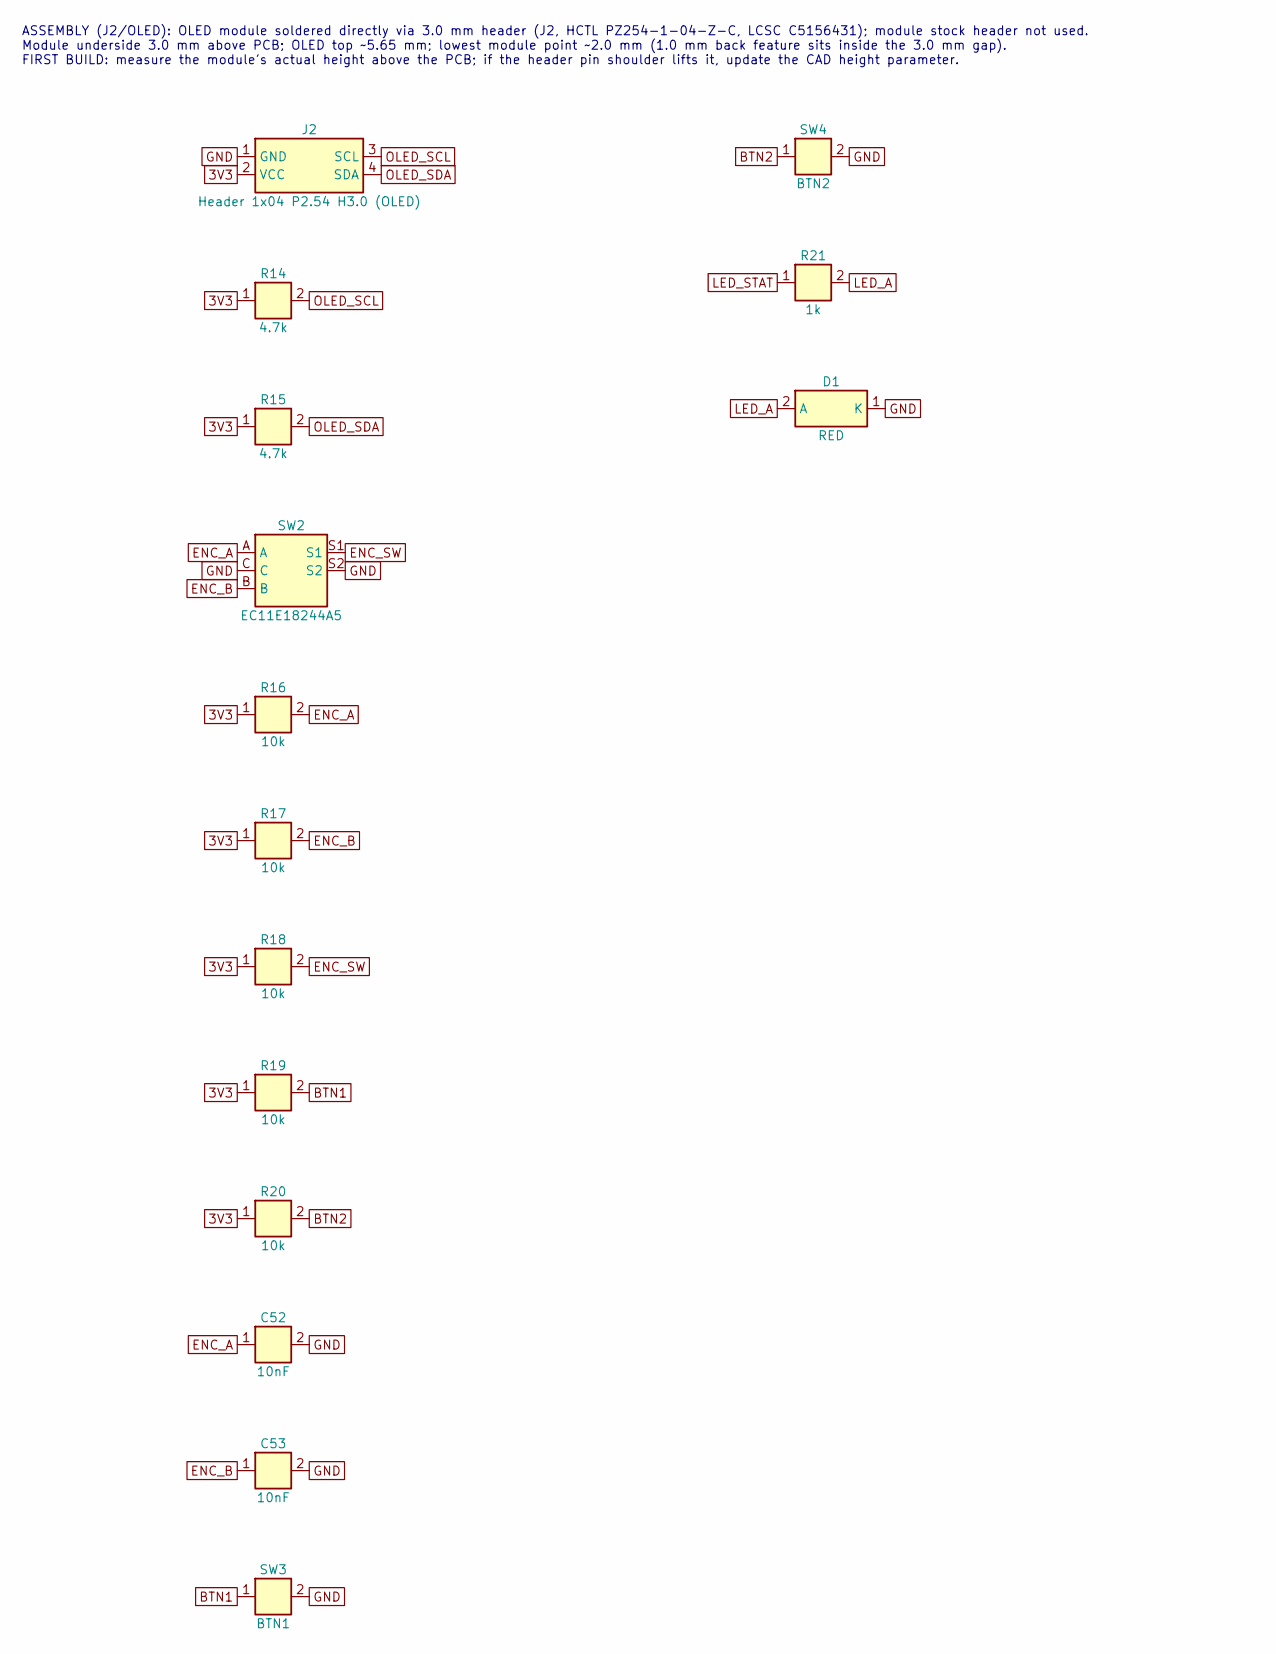
[picture p27: schematic ui.kicad_sch, UI: OLED, encoder, buttons, LED]

Parts:
C52, C53: 10nF; C_0402_1005Metric; MPN CL05B103KB5NNNC; LCSC C15195
D1: RED; LED_0603_1608Metric; MPN KT-0603R; LCSC C2286
J2: Header 1x04 P2.54 H3.0 (OLED); PinHeader_1x04_P2.54mm_Vertical; MPN PZ254-1-04-Z-C; LCSC C5156431
R14, R15: 4.7k; R_0402_1005Metric; MPN 0402WGF4701TCE; LCSC C25900
R16, R17, R18, R19, R20: 10k; R_0402_1005Metric; MPN 0402WGF1002TCE; LCSC C25744
R21: 1k; R_0402_1005Metric; MPN 0402WGF1001TCE; LCSC C11702
SW2: EC11E18244A5; RotaryEncoder_Alps_EC11E-Switch_Vertical_H20mm; MPN EC11E18244A5; LCSC C255515
SW3: BTN1; SW_SPST_B3U-1000P; MPN B3U-1000P; LCSC C231329
SW4: BTN2; SW_SPST_B3U-1000P; MPN B3U-1000P; LCSC C231329

Connections:
3V3: J2.2 (VCC), R14.1, R15.1, R16.1, R17.1, R18.1, R19.1, R20.1; also elsewhere on the board
BTN1: R19.2, SW3.1; also elsewhere on the board
BTN2: R20.2, SW4.1; also elsewhere on the board
ENC_A: C52.1, R16.2, SW2.A; also elsewhere on the board
ENC_B: C53.1, R17.2, SW2.B; also elsewhere on the board
ENC_SW: R18.2, SW2.S1; also elsewhere on the board
GND: C52.2, C53.2, D1.1 (K), J2.1 (GND), SW2.C, SW2.S2, SW3.2, SW4.2; also elsewhere on the board
LED_A: D1.2 (A), R21.2
LED_STAT: R21.1; also elsewhere on the board
OLED_SCL: J2.3 (SCL), R14.2; also elsewhere on the board
OLED_SDA: J2.4 (SDA), R15.2; also elsewhere on the board

Notes on the sheet:
ASSEMBLY (J2/OLED): OLED module soldered directly via 3.0 mm header (J2, HCTL PZ254-1-04-Z-C, LCSC C5156431); module stock header not used. Module underside 3.0 mm above PCB; OLED top ~5.65 mm; lowest module point ~2.0 mm (1.0 mm back feature sits inside the 3.0 mm gap). FIRST BUILD: measure the mo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

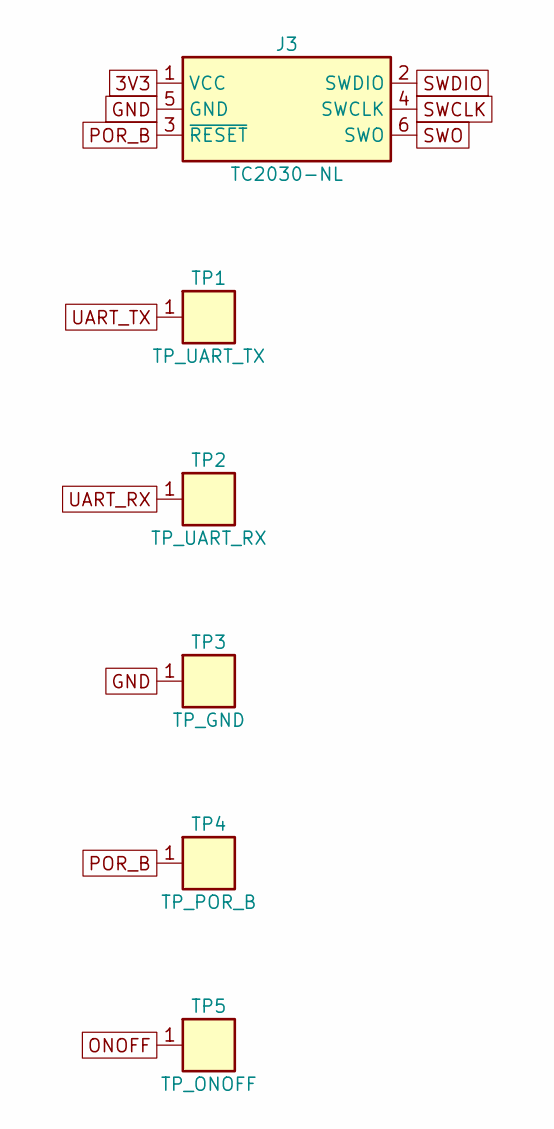
[picture p28: schematic debug.kicad_sch, Debug: TC2030-NL SWD, UART/reset test pads]

Parts:
J3: TC2030-NL; Tag-Connect_TC2030-IDC-NL_2x03_P1.27mm_Vertical; MPN N/A - footprint only; LCSC N/A - footprint only
TP1: TP_UART_TX; TestPoint_Pad_D1.0mm; MPN N/A - footprint only; LCSC N/A - footprint only
TP2: TP_UART_RX; TestPoint_Pad_D1.0mm; MPN N/A - footprint only; LCSC N/A - footprint only
TP3: TP_GND; TestPoint_Pad_D1.0mm; MPN N/A - footprint only; LCSC N/A - footprint only
TP4: TP_POR_B; TestPoint_Pad_D1.0mm; MPN N/A - footprint only; LCSC N/A - footprint only
TP5: TP_ONOFF; TestPoint_Pad_D1.0mm; MPN N/A - footprint only; LCSC N/A - footprint only

Connections:
3V3: J3.1 (VCC); also elsewhere on the board
GND: J3.5 (GND), TP3.1; also elsewhere on the board
ONOFF: TP5.1; also elsewhere on the board
POR_B: J3.3 (~RESET), TP4.1; also elsewhere on the board
SWCLK: J3.4 (SWCLK); also elsewhere on the board
SWDIO: J3.2 (SWDIO); also elsewhere on the board
SWO: J3.6 (SWO); also elsewhere on the board
UART_RX: TP2.1; also elsewhere on the board
UART_TX: TP1.1; also elsewhere on the board

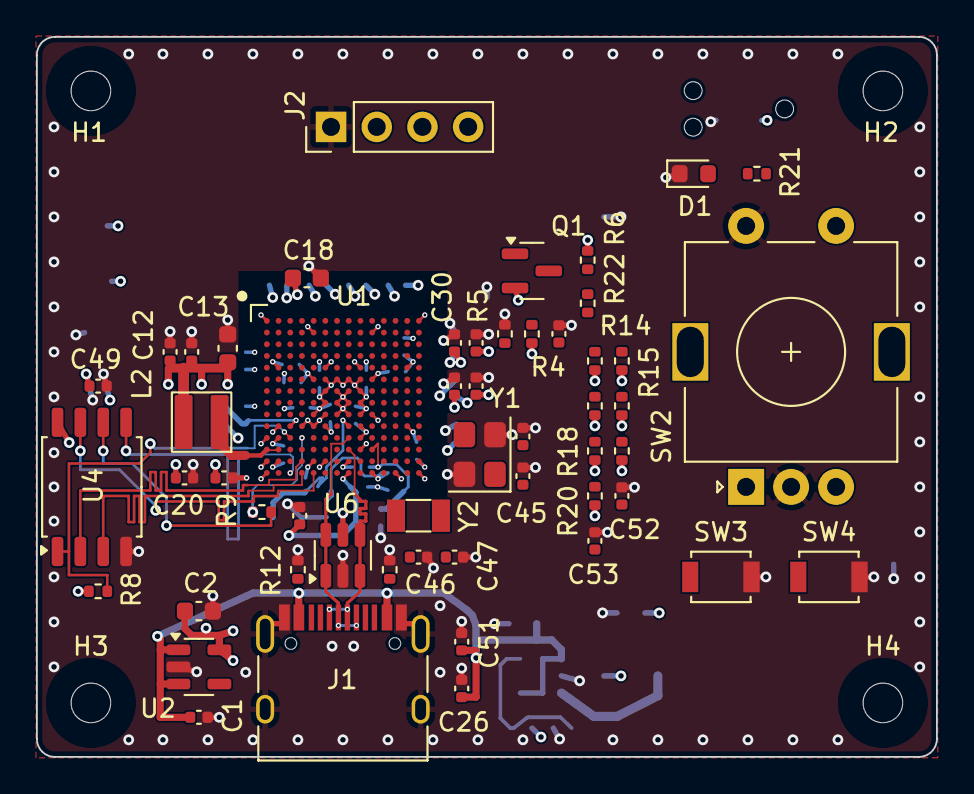
[picture p29: board TokenKey-RT.kicad_pcb from above]

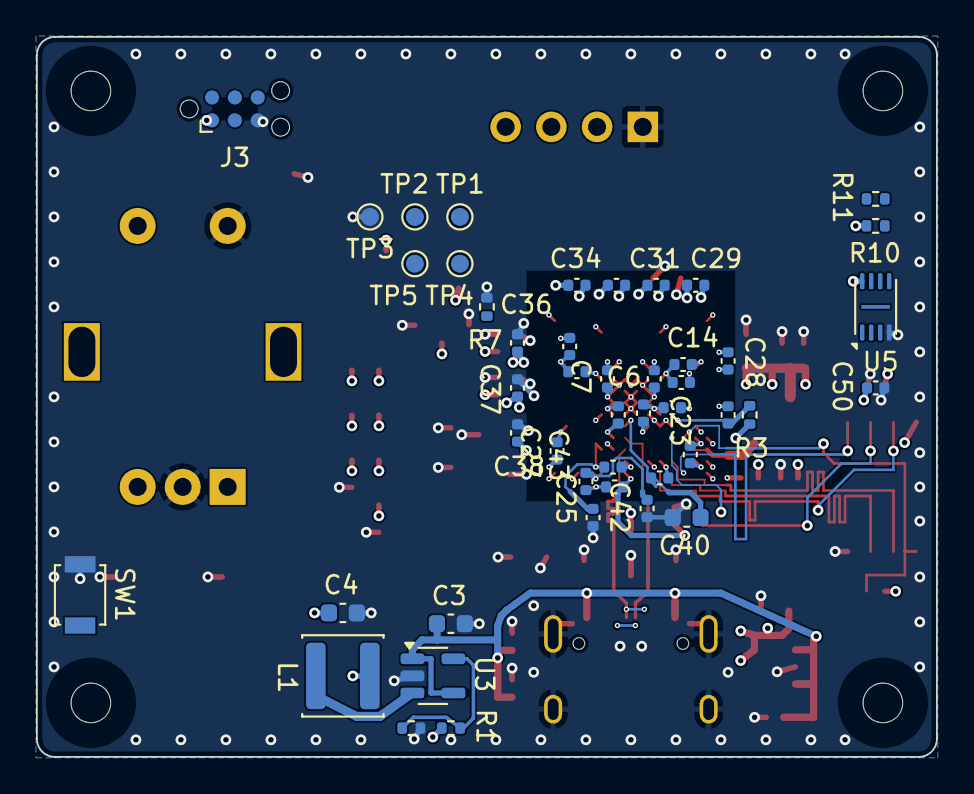
[picture p30: board TokenKey-RT.kicad_pcb from below]

Board: 4 copper layers, 50.0 x 40.0 mm, 103 parts (46 on the bottom side), 54 nets.

Other parts of the board:
H1, H2, H3, H4: M2; MountingHole_2.2mm_M2
