anand2532/TokenKey-RT/(commit log)

2026-10-19 Consolidate KiCad project in hardware/schematic/ and remove hardware/pcb (Fixes #5)
2026-10-19 Schematic baseline: hierarchical KiCad schematic + pin map
    - hardware/schematic/: TokenKey-RT root + power, mcu, flash, usb, ui, debug sheets
    - hardware/libraries/: custom MIMXRT1062DVL6B 5-unit symbol and
    MAPBGA-196 10x10 mm 0.65 mm footprint (from IMXRT1060CEC Tables 82/83)
    - MPN + LCSC fields on all parts; LED_STAT moved K10 -> H13
    - docs/pin-map.md; generator scripts in hardware/schematic/tools/
    - kicad-cli sch erc: 0 errors, 0 warnings
    Fixes #8
    [TokenKey-RT.kicad_sch, debug.kicad_sch, flash.kicad_sch, mcu.kicad_sch, power.kicad_sch, ui.kicad_sch, usb.kicad_sch]
2026-10-19 Layout spec: outline, M2 holes, JLC04161H-3313 stackup, design rules and staged .kicad_dru
    - docs/layout-notes.md: 50x40 R1 outline + lower-left aux origin, 4x M2
    holes with 5 mm keepouts, JLC04161H-3313 stackup, board-setup floors,
    BGA 0.20/0.35 via (small-via surcharge, hole-to-track caveat, POFV
    fallback), net classes (Default/Power/USB_HS/BGA_Escape), USB 90R
    0.155/0.20 (JLC calculator, FD cross-check), USB-C placement, zoning
    plan and open questions.
    - hardware/schematic/TokenKey-RT.kicad_dru.staged: custom rules,
    validated with kicad-cli 9.0.2 DRC on a throwaway board.
    Fixes #13
2026-10-19 Update layout decisions: BGA via, netclasses, board/OLED, USB-C edge (Fixes #15)
2026-10-19 Schematic baseline: BGA land pattern, OLED module, 220nF second source
    - U1 footprint: per NXP SOT1546-2 / case outline 98ASA01088D Rev O
    (IMXRT1060CEC Rev 4 Fig. 53; balls d0.25-0.35) and NXP AN4982 Rev 4
    s4.2: 0.325 mm NSMD Cu pads, 0.450 mm mask opening (was 0.30 mm guess)
    - J2 OLED: HS HS96L03W2C03, LCSC C5248080 (SSD1315, SSD1306-compatible);
    pins 1 GND 2 VCC 3 SCL 4 SDA per datasheet V1.0 (matches existing
    nets); 3.3 V max, no onboard LDO, external pull-ups R14/R15 kept;
    27.3x27.8 mm, 4x d2.5 holes on 23.3x23.8 mm
    - 220nF 0402: add MPN_Alt CL05B224KO5NNNC / LCSC_Alt C16772 (16V X7R)
    as second source to C47129 on all 14 parts
    - docs/pin-map.md and generators updated to match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
    [power.kicad_sch, ui.kicad_sch]
2026-10-19 Resolve layout open questions 1 and 6; BGA via 0.15/0.30, Power trunk/branch (Fixes #15)
2026-10-19 Layout follow-up: BGA via 0.15/0.30, PM net classes, OLED keep-under, stack height
    - Staged .kicad_dru: BGA via 0.15/0.30, JLC 0.2 mm via-hole-to-track rule
    everywhere (0.17 exception removed), Power 0.30 min / 0.40 opt,
    keep-under-OLED comment, tented-via note.
    - layout-notes: section 4.2 locked 0.15/0.30 with geometry, JLC quote and
    via-covering open item; Board Setup via floor 0.30/0.15; USB-C south edge
    decided; keep-under-OLED area (2.5 mm max); stack height; netlist import
    waits for schematic PR #10; re-validation results.
    Fixes #19
2026-10-19 PM review fixes: boot R_S, C51, decap note, notes, BOM fields
    - MUST: add R22 (R_S) 1k 0402 0402WGF1001TCE / C11702 between Q1 drain
    (pin 3, new net BOOT_MODE0_Q) and BOOT_MODE0 (F11)
    - C51 VBUS bulk 10uF 0603 -> 4.7uF 0402 (CL05A475MP5NRNC / C23733)
    - docs/decisions.md: keep C11/C12; VDD_SOC total 32.5uF vs HDG ~33uF
    - U3 description and root note: buck inductor is L1 (was "L2")
    - mcu sheet note: WAKEUP (L6) / ONOFF (M6) rely on internal 100k PU
    - APS6404L-3SQR-ZR pinout + USON-8 footprint checked vs AP Memory
    datasheet Rev 2.3 (no change); GPIO_SD_B0_04 ALT4 = FLEXSPIB_SS0_B
    confirmed in SDK fsl_iomuxc.h (H2 per DS Table 83)
    - J3 TC2030 and TP1-TP5: MPN/LCSC "N/A - footprint only" +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
    [TokenKey-RT.kicad_sch, debug.kicad_sch, mcu.kicad_sch, power.kicad_sch, usb.kicad_sch]
2026-10-19 BOM: second source for 4.7uF 0402 (C23733 out of stock)
    - MPN_Alt CL05A475KP5NRNC / LCSC_Alt C368809 (Samsung, 4.7uF 10V X5R
    +/-10% 0402, 1,355,750 in stock at LCSC on 2026-10-19) on all 12
    4.7uF parts (C11, C12, C17, C20, C22, C25, C30, C32, C35, C39, C42, C51)
    - primary CL05A475MP5NRNC / C23733 kept; out of stock at LCSC today
    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
    [power.kicad_sch, usb.kicad_sch]
2026-10-19 PCB: create board, import netlist, place components (both sides)
    - TokenKey-RT.kicad_pcb from the schematic via the KiCad MCP connector:
    99 footprints, 54 nets, 50x40 R1 outline, 4 copper layers (In1 GND,
    In2 PWR), 4x M2 holes (H1-H4), aux/grid origin lower-left
    - Placement top and bottom per docs/layout-notes.md section 13; no routing
    - Activate TokenKey-RT.kicad_dru (renamed from .staged); add the M2 hole
    copper keepout rule; USB keep-away rule skips pad-to-pad pairs
    - .kicad_pro: net classes, net-class patterns, Board Setup floors, sheets kept
    - layout-notes: OLED keep-under cap 2.0 mm, placement summary
    - Ignore *_drc_violations.json
    DRC: 0 errors, 136 silk warnings, 272 unconnect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
    [TokenKey-RT.kicad_pcb]
2026-10-19 L2: low-profile 4.7uH DCDC inductor (TDK VLS3015CX-4R7M-1, alt SWPA3015S4R7MT) + OLED mechanical data
    - L2 (power.kicad_sch, via KiCad MCP edit_schematic_component): VLS3015CX-4R7M-1 / C3220938,
    3.0x3.0x1.5 mm max, DCR 0.137R max, Isat 1.37A; MPN_Alt SWPA3015S4R7MT / LCSC_Alt C19398.
    - New footprint TokenKey:L_3.0x3.0mm_TDK_VLS3015CX (TDK land: 2x 1.0x3.0 mm pads, +/-1.0 mm),
    created with the MCP create_footprint tool.
    - docs/decisions.md: L2 rationale + HS96L03W2C03 mechanical offsets.
    - pin-map note updated. run_erc: 0 violations.
    Fixes #24
    [power.kicad_sch]
2026-10-19 FreeRTOS firmware skeleton (Fixes #21)
    [app.h, board.c, board.h, boot_hdr.c, input.c, main.c, oled.c, oled.h]
2026-10-19 PCB follow-up (PR #23 review): M2 keepouts, real OLED outline, U4/J2 moves, stackup, DNP, silk pass
    - H1-H4: 5 mm all-copper-layer keepout rule areas (tracks/vias/pads/pours/footprints)
    - OLED: HS96L03W2C03 module outline (x 6.50-33.80, y 4.06-31.86), glass, holes, OLED_KEEP_UNDER rule area
    - J2 moved 0.8 mm north (y 6.3 -> 5.5) so the module clears the J1 USB-C body by 0.74 mm
    - U4 moved 0.45 mm west (3.5 -> 3.05): courtyard 0.505 mm outside the module
    - L2: 4.0x4.0 reservation marked; VLS3015CX swap follows schematic #24
    - JLC04161H-3313 stackup in (setup (stackup)), ENIG
    - DNP on C3 C4 C50 L1 R1 R2 R10 R11 U3 U5; J3/TP1-TP5 excluded from BOM/pos
    - Silk pass: 0 silk_overlap / silk_over_cop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
    [TokenKey-RT.kicad_pcb]
2026-10-19 Layout minimums: raise min track/clearance floors 0.09 -> 0.10 mm
    - .kicad_pro board.design_settings.rules: min_track_width 0.1, min_clearance 0.1
    (hole-to-hole 0.25, via 0.30/0.15, copper-to-edge 0.3 unchanged)
    - .kicad_dru: BGA escape track/clearance and USB neck-down mins 0.10 (opt 0.10); header comment
    - layout-notes: 0.10 floors chosen for margin over JLC's 0.09
    - DRC: 0 errors, 6 warnings (2 J1 silk-edge, 4 H lib-mismatch), 272 unconnected (unrouted)
2026-10-19 Enclosure: research, OLED window/standoff analysis and design directions
    - enclosure/research.md: cited user research (macro pads, Stream Deck,
    knob controllers, hardware tokens, OLED gadgets), board facts from
    PR #23 (cfc9bc3), HS96L03W2C03 window/height/standoff and USB-C
    clearance from PR #25 decisions, three directions, recommendation
    (flat puck with service hatch + BOOT pinhole) and open decisions
    - enclosure/README.md: scope and board refs used
    - enclosure/tools: board_extract.py (pcbnew) and oled_geometry.py
    Fixes #29
2026-10-19 docs: OLED HS96L03W2C03 back-side 1.0 mm feature from datasheet side view
    Item 2 of #32. Item 1 (J3/TP1-TP5 in_bom no) is NOT done: the KiCad MCP
    connector has no tool for the symbol in_bom attribute.
    Refs #32
2026-10-19 BOM: exclude J3 (TC2030) and TP1-TP5 from BOM (in_bom no)
    Scripted hand edit of hardware/schematic/debug.kicad_sch (PM-approved
    exception): the KiCad MCP connector has no tool for the symbol in_bom
    attribute. A Python script changed (in_bom yes) -> (in_bom no) on the
    J3 and TP1-TP5 symbol lines only; git diff = 6 lines, in_bom token only.
    run_erc (user-kicad): 0 violations. export_sch_bom confirms the six refs
    are absent from the BOM.
    Fixes #32
    [debug.kicad_sch]
2026-10-19 docs/poc: software prototype results (G1 not passed, G5 passed)
    Fixes #34
2026-10-19 J2: low-profile 1x4 2.54 mm socket, 3.0 mm insulator (XFCN MF254V-11-04-0743)
    Via KiCad MCP edit_schematic_component on ui.kicad_sch:
    - MPN MF254V-11-04-0743 / LCSC C2889986 (XFCN), insulator 3.00+/-0.10 mm
    per XFCN drawing MF254V-11-xx-0743 (2020-04-12).
    - Alt XDM254C-1-04-Z-3.0-G0 / C19184298 (chxunda).
    - Footprint Connector_PinSocket_2.54mm:PinSocket_1x04_P2.54mm_Vertical
    (same pad pattern as before: pin 1 at origin, pitch 2.54 along +y).
    - OLED module kept as Module_MPN/Module_LCSC; BOM_Note: round machined
    pins required on the OLED side.
    run_erc: 0 violations.
    Fixes #36
    [ui.kicad_sch]
2026-10-19 PCB: L2 -> TDK VLS3015CX footprint, J2 to y 5.0, OLED 3.0 mm header data
    - L2: TokenKey:L_3.0x3.0mm_TDK_VLS3015CX at (9.15, 21.4) rot 180, centred in the 4x4 reserve;
    DCDC_LP pad (10.15, 21.4) -> M1 3.04 mm c-c / 2.13 mm pad edge to ball centre
    - J2 (16.34, 5.5) -> (16.34, 5.0): module PCB y 3.56-31.36, 1.24 mm clear of the J1 USB-C body
    - OLED drawings + OLED_KEEP_UNDER re-drawn for J2 y 5.0; added active area, hole pads,
    1.0 mm back-side block band (y +9.3..+12.3 from pin 1)
    - Docs: 3.0 mm OLED header (PM), stack 6.6 mm above PCB / 8.2 mm overall; L2 no longer pending;
    EC11 15 mm shaft (no board change); H1-H4 verified NPTH
    - DRC: 0 errors; 7 warnings (2 J1 silk-edge, 4 H + 1 L2 lib-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
    [TokenKey-RT.kicad_pcb]
2026-10-19 Assembly note: bottom-side THT leads trimmed to <=1.5 mm after soldering
    - Root sheet text note added via KiCad MCP add_schematic_text at (30.48, 25.4).
    - docs/decisions.md row.
    Fixes #37
    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
    [TokenKey-RT.kicad_sch]
2026-10-19 Firmware follow-ups from #28 review (Fixes #30)
    [board.c, boot_hdr.c, w25q_status.py]
2026-10-19 Enclosure: re-check against main 6fb72fa, 3.0 mm OLED header / 6.6 mm design height (#29)
    - Board facts re-extracted from main 6fb72fa (PR #23 merged 8143f18,
    PR #25 merged 2e09fee): J2 at y 5.5, U4 at (3.05, 25); real OLED
    outline on the board matches oled_geometry.py; board L2 footprint
    still SWPA4020 2.0 mm pending schematic sync
    - OLED header 3.0 mm (PM): design top 6.6 mm (3.0 + 3.6), nominal 5.65;
    lid underside 7.0 / top 8.5; window chamfered through the lid
    - U6 / 1.0 mm back-feature clearance resolved (+0.55 mm)
    - USB-C: +0.74 mm at J2 y 5.5, +1.24 mm at y 5.0
    - Direction A body 14.2 mm (was 13.2); B 14.2 / 22.7 mm; stems,
    light pipe and C standoffs updated
    - oled_geometry.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
2026-10-19 Enclosure research: add Decisions (PM review) section (#29)
    - Direction A approved; J2 y <= 5.0 ask; rear USB-C exit with the OLED
    rotated 180 deg in firmware (board south = rear); 15 mm EC11 shaft with a
    radial bearing step; THT <= 1.5 mm; B3U kept with defined-travel
    printed caps; M2 NPTH; <= 2.0 mm under the OLED with a 3.0 mm header
    - Weight and grip ring stay design parameters
    - New conflict: 15 mm shaft vs 15-25 mm knob height (4.5 mm bore
    engagement); other open items listed
    - CAD deferred to a new issue
    Refs #29
2026-10-19 docs: record PM decisions (OLED socket/stack, USB-C rear + OLED_ROTATE_180, EC11 20 mm, Direction A, B3U caps, NPTH, 0.10 minimums)
    Stacked on issue-31-pcb-l2 (PR #41), which already moves layout-notes 11
    to the 3.0 mm header / about 6.6 mm. This corrects the EC11 row #41 added
    (15 mm cancelled, 20 mm kept) and names the J2 socket in 11.
    Fixes #45
2026-10-19 Footprint L_3.0x3.0mm_TDK_VLS3015CX: set SMD attribute (attr smd)
    HAND EDIT (scripted): inserted one line '(attr smd)' into
    hardware/libraries/TokenKey.pretty/L_3.0x3.0mm_TDK_VLS3015CX.kicad_mod.
    The user-kicad set_footprint_type tool only acts on placed PCB
    footprints by reference, not on library footprints, so a minimal
    Python insert was used (PM-approved). Diff: 1 insertion, 0 deletions.
    Verified the footprint loads with kicad-cli fp export svg. Clears the
    footprint-type DRC warning for Layout.
    (cherry picked from commit 21fdfb2cd6b06696b1660e9b4b2de710e5c80674)
    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
2026-10-19 USB protocol v0.2: sessions, delta jobs, protected spans (Fixes #27)
    [proto.c, proto.h, test_proto.c]
2026-10-19 J2/OLED: round machined-pin male header HCTL PZ254-1-04-Z-C (C5156431)
    - J2 (ui.kicad_sch) via user-kicad edit_schematic_component: added
    Module_Header_MPN PZ254-1-04-Z-C, Module_Header_LCSC C5156431,
    Module_Header_Manufacturer HCTL, Module_Header_MPN_Alt TS-104-G-AA,
    Module_Header_LCSC_Alt C3331270; updated BOM_Note.
    - ui sheet assembly note via add_schematic_text at (25.4, 25.4): stock
    square header removed, replaced with the round-pin header; nominal
    stack 3.00 + 3.00 + 2.65 = 8.65 mm above board top.
    Fixes #44
    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
    [ui.kicad_sch]
2026-10-19 J2/OLED re-scope: no socket, module soldered directly to 3.0 mm header
    - J2 (ui.kicad_sch) via user-kicad edit_schematic_component: Value
    "Header 1x04 P2.54 H3.0 (OLED)", footprint
    Connector_PinHeader_2.54mm:PinHeader_1x04_P2.54mm_Vertical, MPN
    PZ254-1-04-Z-C, LCSC C5156431, Manufacturer HCTL, BOM_Note updated.
    Removed MF254V socket alt fields (MPN_Alt, LCSC_Alt) and all
    Module_Header_* fields. Module_MPN/Module_LCSC kept (HS96L03W2C03 /
    C5248080, own BOM line).
    - No square-pin 1x4 2.54 mm header with 3.0 mm plastic found at
    LCSC/JLC (all 2.5 mm), so PZ254-1-04-Z-C used per PM fallback.
    - HAND EDIT (scripted): replaced the string of the existing ui-sheet
    assembly note (user-k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
    [ui.kicad_sch]
2026-10-19 PCB: #38 BOM flags check, board-only holes, parity nets; OLED header notes
    - Sync from schematic (connector): J3/TP1-TP5 flags confirmed to match
    #38 (excluded from BOM and position files).
    - H1-H4 marked board-only (not_in_schematic) through the connector.
    - Hand edit (pcbnew): 109 single-pin "unconnected-(...)" schematic nets
    assigned to their U1/U2/J1 pads to clear the parity net conflicts.
    - J2 and L2 left exactly as on main (a5e07a6). The J2 header footprint
    and 3D model follow #47; the L2 library SMD fix also follows #47.
    - docs: J2 is a 1x04 2.54 mm male header with 3.0 mm plastic and the OLED
    soldered directly (PM). The socket is dropped. Header part per #47
    (HCTL PZ254-1-0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
    [TokenKey-RT.kicad_pcb]
2026-10-19 OLED stack correction: OLED top ~5.65 mm, lowest point ~2.0 mm
    PM correction: the earlier envelope figure double-counted the 1.0 mm
    back feature. Stack above PCB top: module underside 3.0 mm; OLED top
    ~5.65 mm; lowest module point ~2.0 mm (1.0 mm back feature sits inside
    the 3.0 mm gap). Added a first-build check: measure the module's actual
    height above the PCB; if the header pin shoulder lifts it, update the
    CAD height parameter.
    - HAND EDIT (scripted): replaced the string of the ui-sheet assembly
    note (user-kicad has no text edit tool); position/size/uuid unchanged.
    - docs/decisions.md: 'OLED mounting and stack (issue #44)' row updated.
    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
    [ui.kicad_sch]
2026-10-19 PCB: J2 header and L2 from library after #47
    - Merged origin/main (3ba9378, #47) into issue-43-pcb-sync. In
    decisions.md, took main's OLED rows.
    - Schematic-to-board update (connector): J2 value is now "Header 1x04
    P2.54 H3.0 (OLED)" on Connector_PinHeader_2.54mm:PinHeader_1x04_P2.54mm_Vertical.
    Pin 1 stays at (16.34, 5.0), rot 90.
    - Hand edit (pcbnew): J2 MPN PZ254-1-04-Z-C / LCSC C5156431 hidden fields.
    - Hand edit (pcbnew): L2 updated from TokenKey:L_3.0x3.0mm_TDK_VLS3015CX
    (library now has attr smd), with the same position, rotation and nets.
    The connector cannot resolve the project TokenKey library.
    - layout-notes: J2 header/3D-model note; the L2 mismatch is cleared.
    - DRC: 0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
    [TokenKey-RT.kicad_pcb]
2026-10-19 Routing phase 1: In1 GND plane, In2 3V3 plane + VDD_SOC island
    Zones created with the connector's add_copper_pour. Hand edit (pcbnew): the
    connector placed all three on F.Cu, so they were moved to In1.Cu/In2.Cu.
    Also set VDD_SOC priority 1, min width 0.15, and names. Filled.
    Part of #50 (WIP)
    [TokenKey-RT.kicad_pcb]
2026-10-19 Enclosure docs: board ref eb4495a, final 5.65 mm OLED stack, 20 mm shaft knob (#42)
    - Board ref: Layout #31 eb4495a (not on main yet): J2 y 5.0, L2 VLS3015CX
    1.5 mm verified on the board, OLED back-block band
    - OLED stack (PM final): module soldered on a 3.0 mm plastic header, no
    socket or shim; OLED top 5.65 mm (header + 2.65, both parameters);
    lid underside 6.0 / top 7.5; 6.6 mm design height removed
    - Direction A body 13.2 mm; B 13.2 / 21.7 mm; cap stem 6.4, light pipe 6.5
    - Knob: option (b) default, EC11E18244A5 20 mm shaft, 14 mm knob,
    metal-insert option, radial bearing collar; knob top 29.2 mm above desk;
    the 15 mm shaft swap is dropped
    - New: conservative FPC bend clashes w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
2026-10-19 Enclosure CAD: Direction A puck in CadQuery, exports, renders, interference checks (#42)
    - enclosure/cad: params.py (every key dimension), board_ref.json from
    eb4495a, board keep-out model, parts (top shell, bottom tray, hatch
    cover, knob + brass sleeve, 2x B3U caps, light pipe, ballast),
    automated part-vs-board / part-vs-part / knob-push checks,
    build.py + Makefile, README with the parameter table
    - exports: STEP + STL per part, assembly.step, board_keepout.step,
    interference_report.md, summary.json
    - renders: iso, exploded, bottom, rear, OLED/USB-C section
    - Result: 55 x 45 x 13.2 mm, ~30 g; 0 part clashes; conservative FPC
    bend vs USB-C body -0.26 mm (flagged)
    - Prototype mode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
    [assembly.step, ballast.step, ballast.stl, board_keepout.step, bottom_tray.step, bottom_tray.stl, button_cap_btn1.step, button_cap_btn1.stl]
2026-10-19 Routing phase 1 WIP: BGA power/GND ball fanout (0.30/0.15 vias + dogbones)
    Hand edit (pcbnew): the connector's add_via has no size/drill parameters, so
    BGA 0.30/0.15 vias can't be placed with it. 43 vias and 61 dogbones added.
    USB escape sites (x 16.35/17.00/17.65, south of row L) are kept free.
    VDD_SOC island outline was adjusted to the via pattern. Zones refilled.
    Bottom decoupling caps still overlap the via field (re-placement pending),
    so DRC is not clean at this WIP commit.
    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
    [TokenKey-RT.kicad_pcb]
2026-10-19 enclosure: far-edge FPC bend, real EC11E heights, J2 y 4.4 (pending #49)
    #52 FPC bend vs USB-C:
    - The header edge is north; the far (FPC) edge is south, facing J1.
    - Model the bend inside the module outline (0.4 +- 0.2, worst case 0.2),
    14.5 wide, z 4.2-5.65, no wrap; drop the conservative wrap model.
    - FPC -> J1 body +2.04 mm in plan (2.25 3D), module +1.84; lid 0.35 over
    the bend, under solid lid 4.0 mm from the window edge.
    - J2 pin row parametric (J2_Y, default 4.4, board ref 5.0) pending PR #49.
    #54 EC11E18244A5 heights (Alps drawing No.3):
    - Body 4.5, no bushing, shaft tip 24.5 above the PCB, D-flat from 14.5.
    - Lid relief removed (body 1.5 below the lid); Ø11 x 5.0 lid bearing b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
    [assembly.step, ballast.step, board_keepout.step, bottom_tray.step, button_cap_btn1.step, button_cap_btn2.step, hatch_cover.step, knob.step]
2026-10-19 Routing phase 1 WIP: bottom decoupling caps re-placed onto the via grid and connected
    Hand edit (pcbnew script, collision-checked): 18 bottom caps under or near
    the BGA (C6-C10, C14-C16, C19, C21, C23-C25, C27, C40-C43) moved by up to
    1.6 mm so their pads clear the 0.65 mm via grid (no via-in-pad). Each pad
    gets a short B.Cu track to a same-net ball via, or to a new 0.30/0.15 via
    (0.60/0.30 outside the U1 courtyard). Zones refilled.
    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
    [TokenKey-RT.kicad_pcb]
2026-10-19 enclosure: J2 at y 5.0 (PM final), board ref main e2e5ff9, stock-shaft knob
    - Regenerate board_ref.json from main e2e5ff9 (PR #49 merged). J2 (16.34, 5.0),
    L2 VLS3015CX and the OLED outline match eb4495a; only J2's value text and
    unconnected-pad net names changed.
    - J2_Y now follows the board (5.0); drop the 0.6 mm north shift and the
    "pending #49 / J2 4.4" notes.
    - FPC bend -> J1 body +1.44 mm in plan (1.72 3D), module PCB +1.24 mm; lid
    0.35 over the bend. Window centre KiCad (20.15, 15.36).
    - Knob default: stock EC11E18244A5 shaft, 16.5 mm knob (no purchased-part
    mods). The trimmed-shaft 14 mm knob is documented as a measured option only;
    the make variant-trim target is removed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
    [assembly.step, ballast.step, board_keepout.step, bottom_tray.step, button_cap_btn1.step, button_cap_btn2.step, hatch_cover.step, knob.step]
2026-10-19 Routing phase 1 WIP: plane vias for GND/3V3 pads, B.Cu decoupling rails
    Hand edit (pcbnew script, collision-checked): 72 GND/3V3 pads outside the
    ball field get a short track to an own plane via (0.60/0.30; 0.30/0.15 in
    the U1 courtyard). GND via next to U6 USB_DP pad removed (0.5 mm USB
    keep-away). B.Cu grid-routed rails: NVCC_PLL (C42-C43), VDD_SNVS_CAP
    (M10-C24-C25), DCDC_PSWITCH (K3-C5-R3), VDD_USB_CAP (K8-C41-C40),
    VDD_HIGH_CAP (P8-C21-C22). 0.15 mm inside the U1 courtyard, 0.30 outside.
    Part of #57
    [TokenKey-RT.kicad_pcb]
2026-10-21 Deprecate tools/gen.py and gen_pinmap.py; pin-map.md is a frozen snapshot
    gen.py would regenerate the schematic and overwrite hand edits (L2 #24,
    J2 header #44). Both scripts now refuse to run when executed. gen_pinmap.py
    needs netlist.json from gen.py (not in the repo), so docs/pin-map.md is
    now maintained by hand; README documents this. ERC unchanged (0/0).
    Fixes #26
    [gen.py, gen_pinmap.py]
2026-10-21 fab: kicad-cli fab-package pipeline, JLC fab notes, stackup and DFM decisions
    Adds fab/Makefile + fab/scripts (gerbers/drill, JLC CPL/BOM, IPC-D-356,
    assembly PDFs, ERC/DRC gate, zip) writing to gitignored fab/out/<sha>/,
    fab/README.md fab notes (stackup, impedance, netclasses, via aspect ratio,
    via covering for PM decision, OLED stack, order checklist), fab/stackup.md,
    and the DFM decision history in docs/decisions.md.
    Fixes #62
2026-10-21 Pin mux and FlexSPI FCB reconciled with merged schematic (Fixes #64)
    [board.c, boot_hdr.c]
2026-10-21 fab: POFV decision, hand-assembly BOM, KiKit 2x2 panel, aspect-ratio callout
    - fab/README.md, fab/stackup.md: 4L JLC04161H-3313 with board-wide epoxy
    filled & capped vias (6L quote-time comparison only), 10.7:1 callout,
    hand-solder steps (J2, OLED, knob), panel section, updated checklist
    - fab/scripts/hand_assembly.py + fab/hand_assembly.csv: hand_assembly_bom.csv
    (OLED C5248080 from J2 Module_LCSC, knob) kept out of the JLC BOM
    - make_fab.sh/Makefile: KiKit 1.8.1 (pinned) 2x2 panel 102.1x96.1 mm,
    mouse bites, rails, 3 fiducials, tooling holes, panel zip/BOM/CPL; panel target
    - docs/decisions.md: 2026-10-21 PM decisions row
    Fixes #68
    [hand_assembly.csv]
2026-10-21 PoC: refresh prototype-results doc, add software/poc-prototype
    The doc's Status line is fixed, it uses repo paths only, and it adds the offline G2-G4 results.
    The prototype package (code, 13 unit tests, README, REPORT, G2 design
    with dedup-only arm) is from TokenKey PoC; no venv, data or secrets.
    Fixes #70
2026-10-21 enclosure: silicone-foot pockets + maximised steel plate, drop 120 g target (#53)
    PM decision: keep the slim 13.2 mm puck, drop the 120 g target.
    - Five Ø7.9 x 2.2 stock silicone feet (3M Bumpon SJ5302-class; TK_FOOT=10x3
    option) in Ø8.4 x 1.0 pockets, 1.2 mm proud. The NE foot sits in the hatch
    cover (hatch fills that corner); SE + E bracket the BOOT hole / H2 boss.
    Pocket walls >= 0.81 mm (checked by the build). Knob axis 1.8 mm and SW3
    4.2 mm inside the support polygon; SW4 0.5 mm outside but needs ~14.9 N to
    tip (summary.json tip_press_N).
    - Grip-cord groove removed (feet replace it; cord + feet would rock).
    - Steel plate: plate.py computes the largest outline under the board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
    [assembly.step, ballast.step, ballast.stl, ballast_plate.dxf, board_keepout.step, bottom_tray.step, bottom_tray.stl, button_cap_btn1.step]
2026-10-21 enclosure: FreeCAD 1.0 port of the Direction A puck, validated vs CadQuery (#63)
    - puck.FCStd: Params sheet (every params.py scalar, aliased; derived values as
    live formulas), Points + Plate sheets (board-derived XY, steel-plate
    outline), one Part::Feature per part (top shell, tray with foot pockets and
    plate pins, hatch cover, knob, sleeve, B3U caps, light pipe, steel plate,
    feet). assembly.FCStd links the parts + the board keep-out.
    - fc_parts.py: one-to-one Part-API port of cad/parts.py, reads only the sheets;
    rebuild.FCMacro regenerates from edited sheets. build_fc.py / export_params.py
    drive it headless (built via the FreeCAD MCP).
    - STEP + STL per part in freecad/exports/.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
    [assembly.FCStd, ballast.step, ballast.stl, bottom_tray.step, bottom_tray.stl, button_cap_btn1.step, button_cap_btn1.stl, button_cap_btn2.step]
2026-10-21 enclosure: v0.2 print-ready release package (PRINTING, BOM, oriented STLs)
    Stacked on issue-63-53-freecad (825a22d); uses the CadQuery exports.
    - PRINTING.md: per-part material/process, orientation with reasons (top
    shell upright because of the 5 mm knob boss; knob flipped top-down),
    layer/walls/infill/support settings, tolerance + fit table, coupon,
    post-processing (inserts, SLA wash/cure, sleeve press), assembly order,
    fit-print checklist incl. #55 B3U cap force.
    - BOM.md: M2x8 DIN 912 (length derived from the stack), M2x3 heat-set
    inserts (chosen; CAD bosses already Ø3.2 x 5.0), SJ5302-class feet x5,
    1.2 mm laser-cut steel plate (DXF), thin transfer tape, brass D-sleeve
    (se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
    [bottom_tray.stl, button_cap_btn1.stl, button_cap_btn2.stl, hatch_cover.stl, knob.stl, light_pipe.stl, tolerance_coupon.stl, top_shell.stl]
2026-10-21 docs: record PM weight decision for the enclosure (issue #53)
    Refs #53
2026-10-21 enclosure: v1 release decisions - FreeCAD authoritative, silicone feet, print STLs from FreeCAD
    - FreeCAD puck.FCStd is the source of truth; CadQuery kept as reference (docs/READMEs).
    - export_fc.py (rebuild from the FCStd sheets) and print_fc.py (oriented print STLs from FreeCAD).
    - Feet default: silicone 8.0 x 2.2 x5; 3M SJ5302 7.9 x 2.2 alternate; pocket stays 8.4 x 1.0.
    - Flick-spin note; no window pocket / insert in v1.
    - Rebuilt CadQuery reference + revalidated: all parts match, 0 CLASH/TIGHT.
    - Merged origin/main (9bb8f63, PR #73) into the branch.
    Fixes #72
    [assembly.FCStd, assembly.step, ballast.step, board_keepout.step, bottom_tray.step, bottom_tray.stl, button_cap_btn1.step, button_cap_btn1.stl]
2026-10-21 enclosure: BOM feet row - silicone default, SJ5302 alternate
    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
2026-10-21 Routing phase 1: DCDC loop, VDD_SOC output, input caps; free the USB corridor
    DCDC: L2.1 (DCDC_LP) to M1 on F.Cu, 0.50 mm outside the U1 courtyard,
    0.25 mm neck between the L1/N1 dogbones, 0.10 mm M1-M2 link. L2.2 (VDD_SOC)
    0.60 mm to a 0.50 mm bar on C12/C11/C13 pad 1, three 0.6/0.3 vias into the
    In2 VDD_SOC island. C17/C20 (3V3 input) each get their own 3V3/GND via
    north of the pads (C17.2 east, at the courtyard edge).
    USB corridor (x 15.5-18.5 south of the BGA): removed three dangling vias
    from c955b6a that sat in the DP/DN path (NVCC_PLL 15.45,25.72; VDD_SNVS_CAP
    18.45,26.22; VDD_USB_CAP 13.125,27.6) with their tails. VDD_HIGH_CAP B.Cu
    rail C21-C22 moved from x 17.0 to x 17.72 so the U6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
    [TokenKey-RT.kicad_pcb]
2026-10-21 Routing phase 1: power entry (VBUS, LDO, spare buck) and plane vias
    VBUS: J1 vias to a 0.40 mm B.Cu trunk. West: B.Cu to a via at (6.7, 33.3),
    F.Cu rail west of U2 to U2.1/U2.3 and C1.1. East: B.Cu to C51/C26 (F.Cu
    via at 24.4, 34.5), C3.1 and U3.1; U3.1-U3.4 (VIN/EN) under the U3 body.
    VBUS sense: U6.5 and ball N6 tied on In2 by a 0.30 mm VBUS track
    (N6 via - U6.5 via - J1 east VBUS via); the 3V3 plane flows around it.
    U2.5 (3V3 out) to C2.1 plus three 3V3 plane vias. Spare buck (DNP):
    BUCK_SW 0.50 mm on B.Cu south of L1.2 (far from Y1/Y2), BUCK_FB 0.20 mm.
    Own GND via for C1, C2, U2, C51, C26, C3, U3, J3.5, C11, C12, C13; 3V3 via
    for J3.1. C40.2/C42.2 tied on B.Cu to the C22 GND via.
    Hand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
    [TokenKey-RT.kicad_pcb]
2026-10-21 Routing phase 1: GND stitching, outer GND pours, cleanup
    GND pours on F.Cu and B.Cu (GND_POUR_TOP/BOT: 0.30 mm clearance, 0.20 mm
    min width, solid SMD / thermal THT, islands removed) with a NO_POUR_U1 rule
    area over the BGA and its bottom decoupling (x 11.2-22.8, y 13-25.8) so the
    pour does not starve the 0402 thermals or fill the escape channels.
    61 GND stitching vias (0.6/0.3): ring 0.95 mm in from the board edge at
    about 2.5 mm pitch (skipping the H1-H4 keepouts, J3 rule area and parts),
    plus three beside the J1 shell. Removed two single-layer vias left from
    c955b6a (VDD_SNVS_CAP 18.95,22.6; VDD_USB_CAP 15.605,24.976).
    Result: DRC 0 errors, 20 warnings (pre-existing silk/lib); 0 unconnec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
    [TokenKey-RT.kicad_pcb]
2026-10-21 Route USB HS pair U1 -> USBLC6 -> J1 on L1 (Part of #58)
    B-row J1 ties and diff-pair gap/uncoupled DRC errors remain open; see layout-notes §5.
    [TokenKey-RT.kicad_pcb]
2026-10-21 Protocol v1.0 end to end: PoC context engine, sessions, tkhost + simulator, UI, watchdog safe mode (Fixes #65)
    - engine.c/jobs.c/xxh32.c: byte-exact port of the TokenKey PoC rules (SPEC.md) with bounded
    state: streaming scanner (2048 B line cap, one-line lookahead), 4096-segment table, per-session
    dupset (8192 slots), keep/drop records, pass 2 for the diff reference bonus, rollback
    - proto: v1.0 wire (minor 3): message table (role/flags), SPAN_ERROR, JOB_END 27 B with status,
    13 B RESULT_READ records, 5 modes (S-protect default, dedup-only), policy TLVs, EXPIRED
    - tools/tkhost.py: CLI + reference client (simulator via libtksim.so or USB), host-side lapse/TTL
    - tests: test_engine.c, gol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
    [app.h, board.c, board.h, engine.c, engine.h, jobs.c, jobs.h, main.c]
2026-10-21 USB HS: J1 B-row via-in-pad ties, 45R uncoupled width, DRU exception
    Fixes #58
    [TokenKey-RT.kicad_pcb]
2026-10-21 fab: J1 B-row via-in-pad requires POFV; knob is printed + brass sleeve
    [hand_assembly.csv]
2026-10-21 Route QSPI flash nets (CS/SCLK/IO0-3) to U4, length-matched
    Fixes #59
    [TokenKey-RT.kicad_pcb]
